MrJake222/pico-radio-docs/img/5/hw_result.jpg

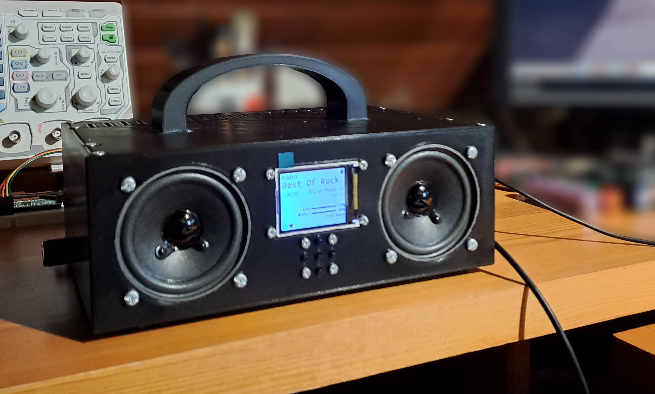
img/5/hw_result.jpg
