MrJake222/pico-radio-docs/img/5/search.jpg

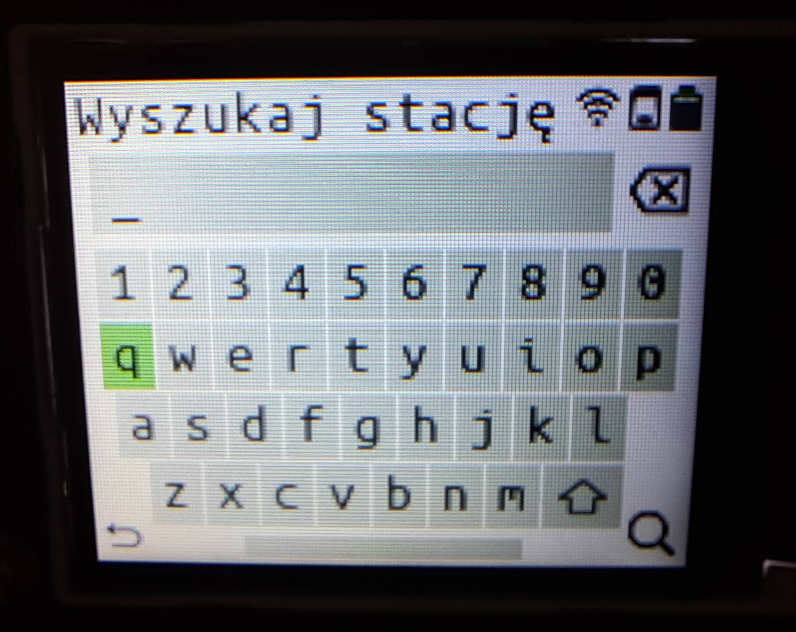
img/5/search.jpg
