MrJake222/pico-radio-docs/img/3/PicoRadio-dma-buf.pdf

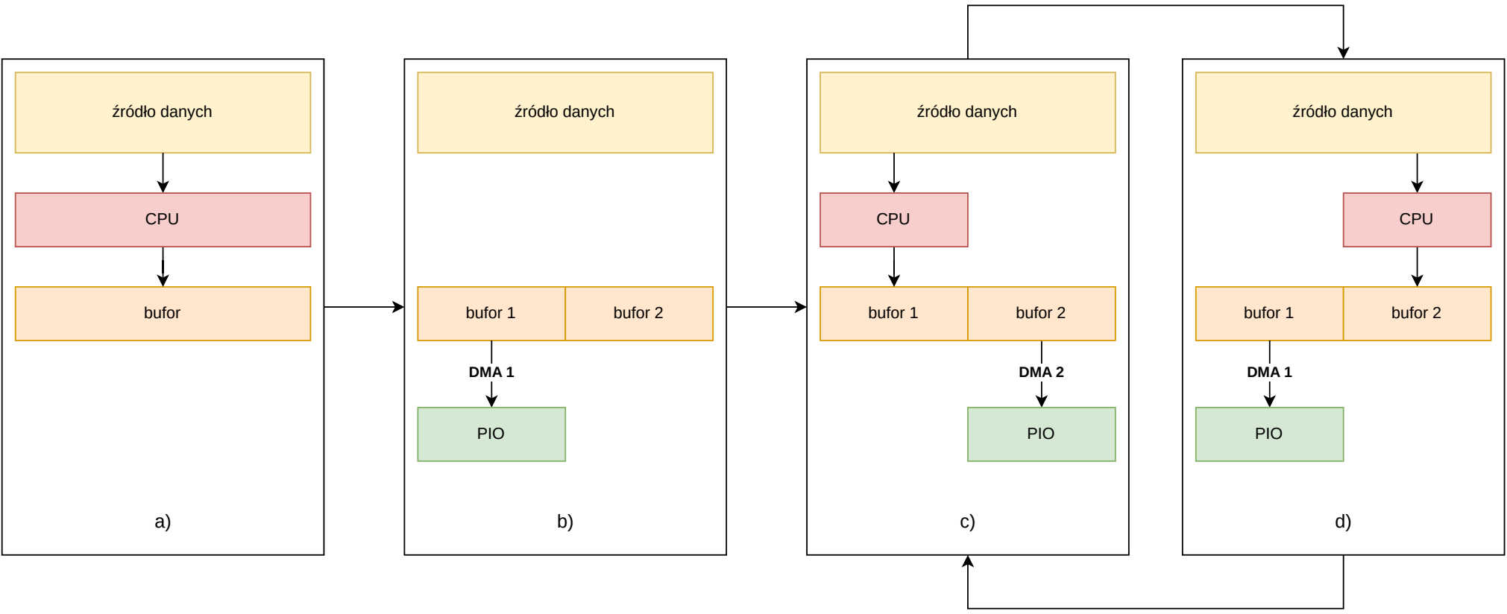
[picture p3: figure]
źródło danych; bufor 1; DMA 2; bufor 2; CPU; PIO; DMA 1; bufor
