MrJake222/pico-radio-docs/img/3/PicoRadio-buffer.pdf

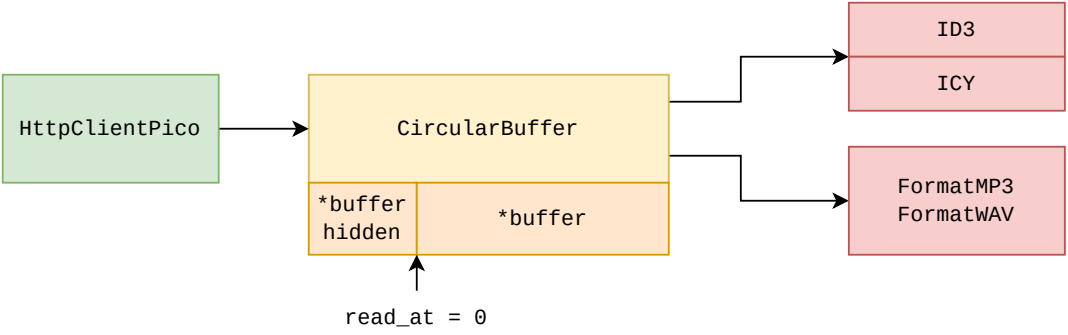
[picture p4: figure]
HttpClientPico; CircularBuffer; ICY; FormatMP3 FormatWAV *buffer; hidden; *buffer; read_at = 0
