MrJake222/pico-radio-docs/img/3/PicoRadio-code-block-diagram.pdf

FreeRTOS

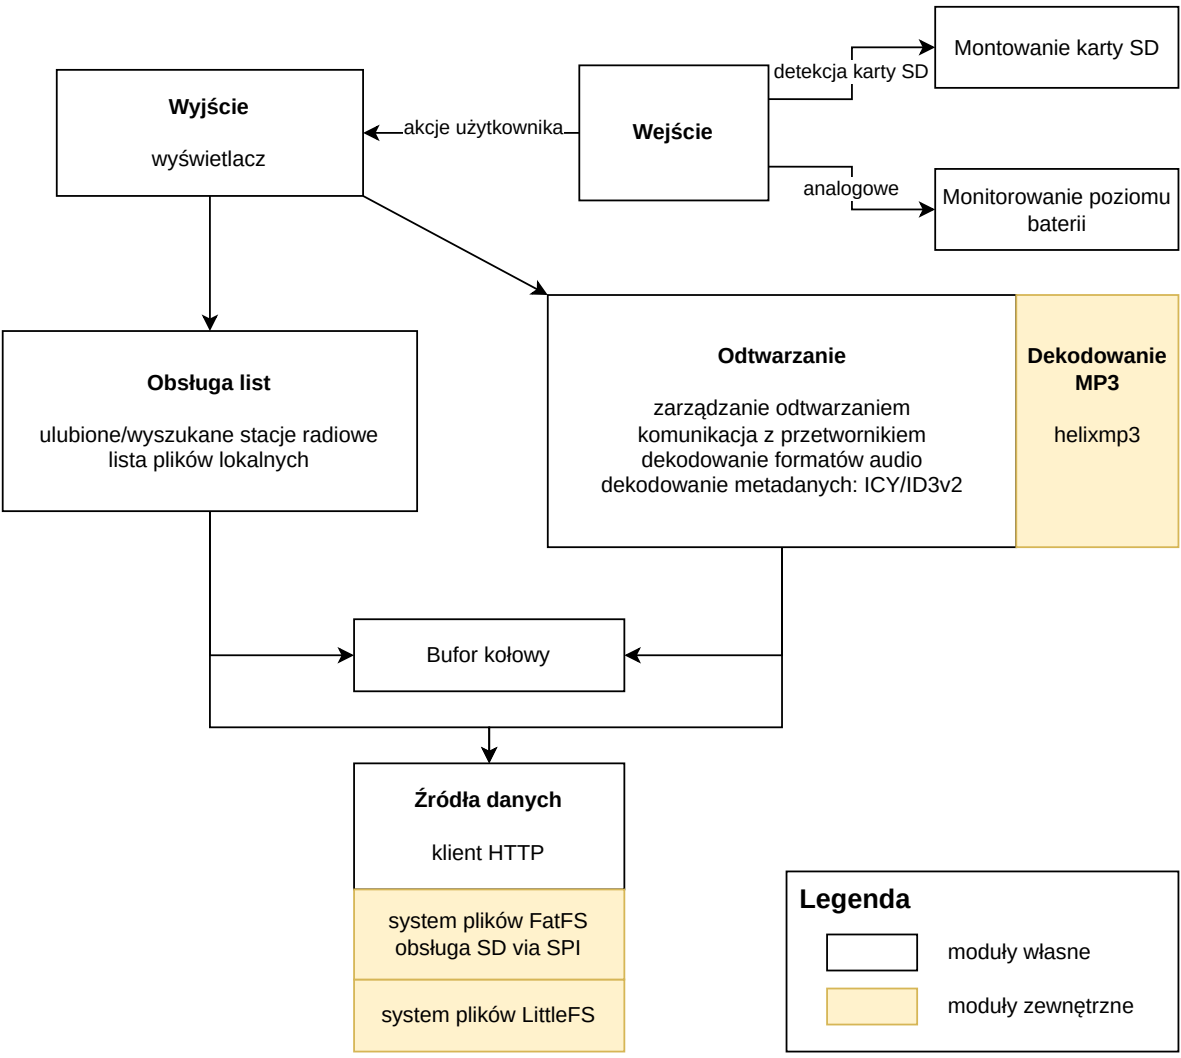
[picture p5: figure]
akcje użytkownika; analogowe; detekcja karty SD; Wejście; Wyjście; wyświetlacz; Odtwarzanie; zarządzanie odtwarzaniem komunikacja z przetwornikiem dekodowanie formatów audio dekodowanie metadanych: ICY/ID3v2; Bufor kołowy; Obsługa list; ulubione/wyszukane stacje radiowe lista plików lokalnych; Montowanie karty SD; Monitorowanie poziomu baterii; Dekodowanie MP3; helixmp3; Legenda; moduły własne; Źródła danych; klient HTTP; system plików LittleFS; system plików FatFS obsługa SD via SPI; moduły zewnętrzne
