MrJake222/pico-radio-docs/img/3/PicoRadio-icy.pdf

Ramka MP3 (np. 418 bajtów) + ramka ICY

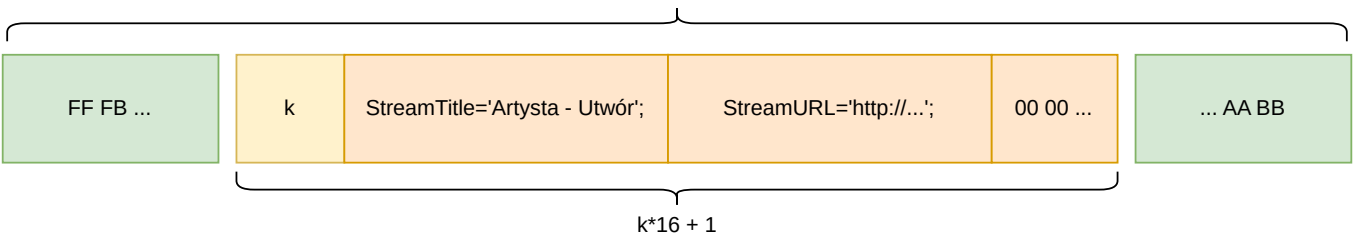
[picture p6: figure]
StreamTitle='Artysta - Utwór';; StreamURL='http://...';
