MrJake222/pico-radio-docs/img/3/PicoRadio-id3.pdf

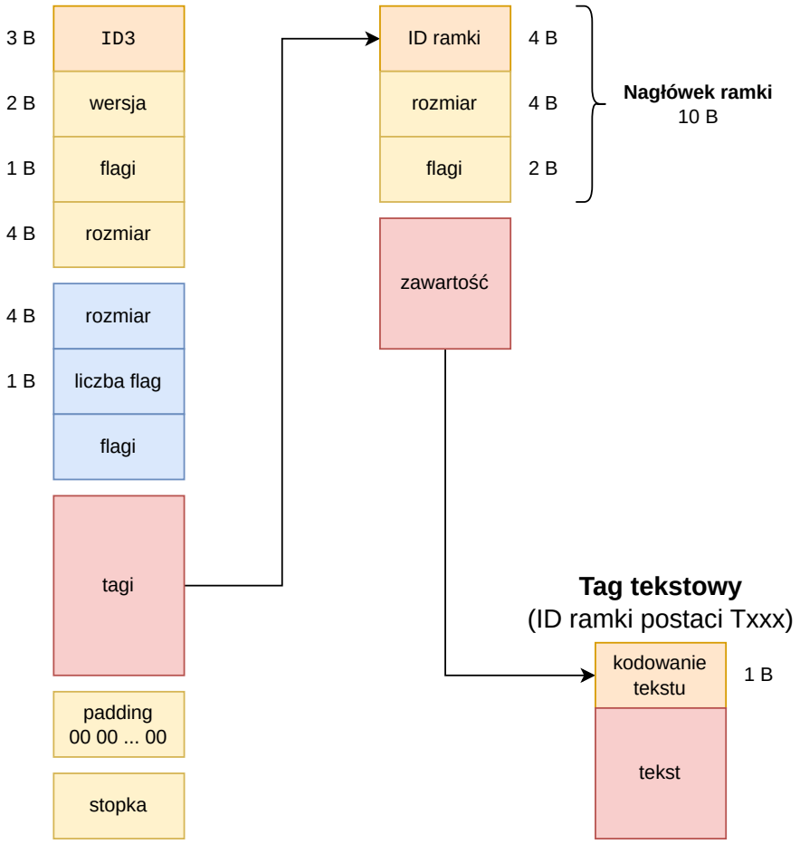
[picture p7: figure]
wersja; flagi; rozmiar; liczba flag; tagi; padding 00 00 ... 00; stopka; ID ramki; Nagłówek ramki 10 B; zawartość; kodowanie; tekstu; tekst; Tag tekstowy (ID ramki postaci Txxx)

Nagłówek
10 B

Nagłówek
rozszerzony
(opcja)
Tag ID3v2 | Ramka (tag)
