MrJake222/pico-radio-docs/img/3/PicoRadio-loaders.pdf

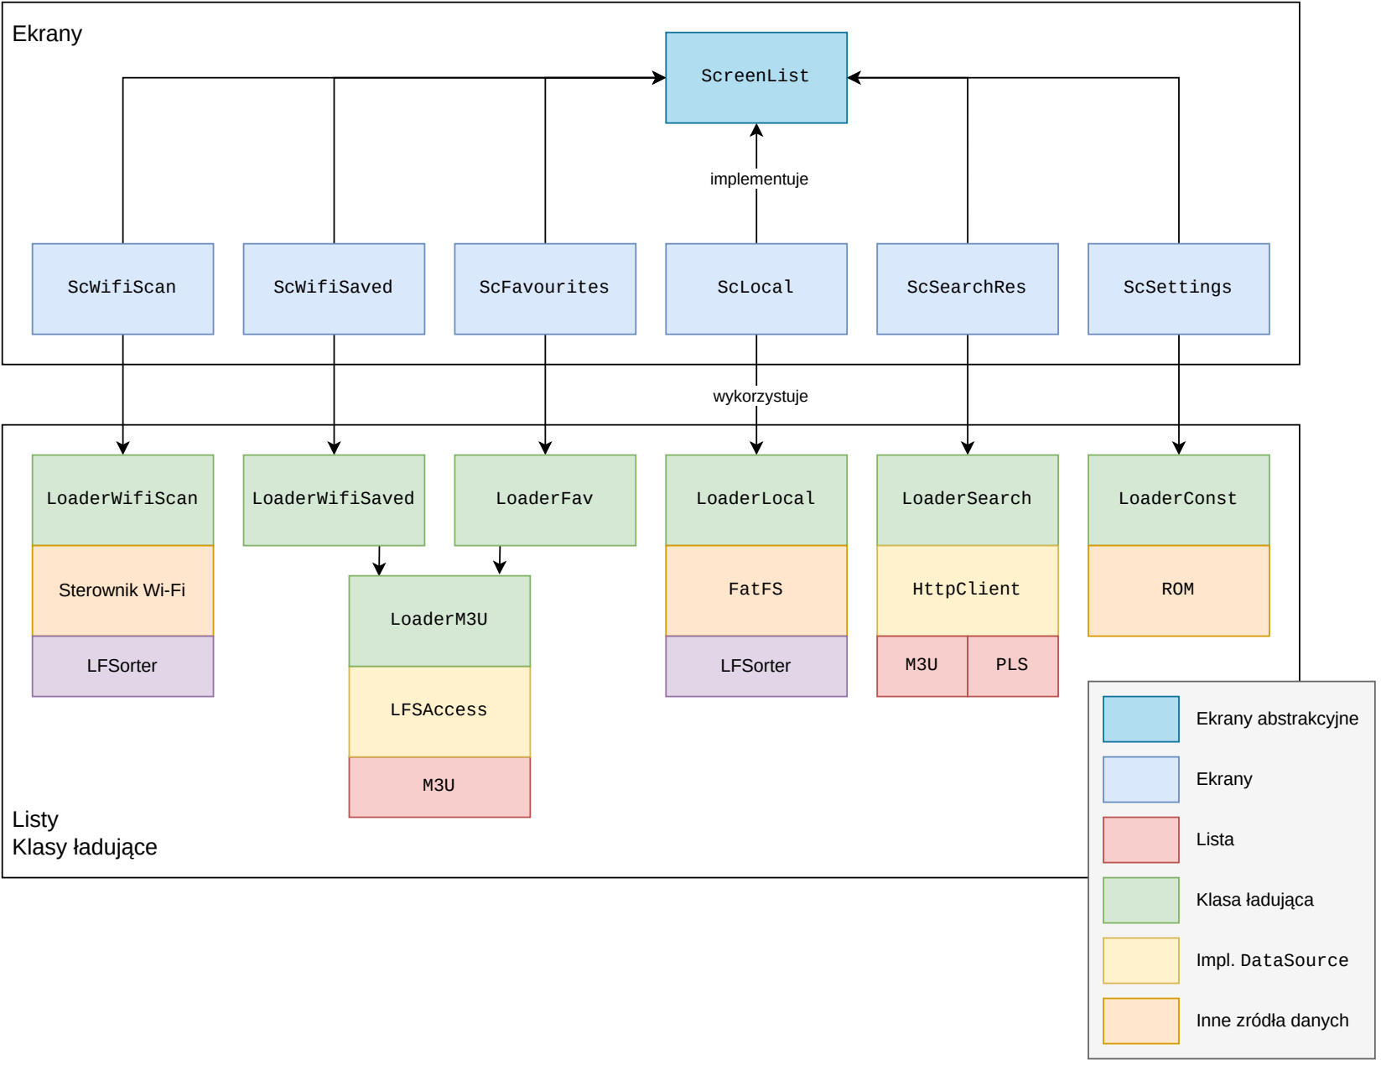
[picture p8: figure]
LoaderFav; LFSAccess; wykorzystuje; LoaderLocal; FatFS; LoaderSearch; HttpClient; PLS; ScFavourites; implementuje; ScLocal; ScSearchRes; ScreenList; Ekrany; Listy Klasy ładujące; Klasa ładująca; Lista; Impl. DataSource; Ekrany abstrakcyjne; ScWifiScan; ScWifiSaved; ScSettings; LoaderWifiScan; LoaderWifiSaved; LoaderConst; ROM; LoaderM3U; Sterownik Wi-Fi; Inne zródła danych; LFSorter
