MrJake222/pico-radio-docs/img/3/PicoRadio-screen-rect.pdf

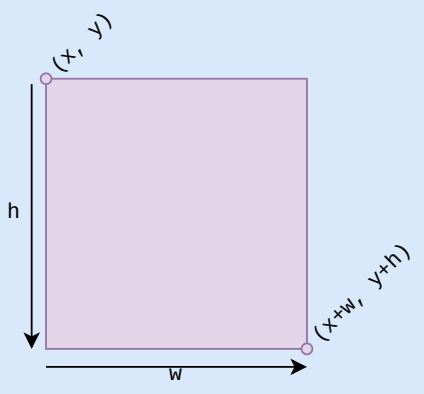
[picture p9: figure]
