MrJake222/pico-radio-docs/img/3/PicoRadio-screens.pdf

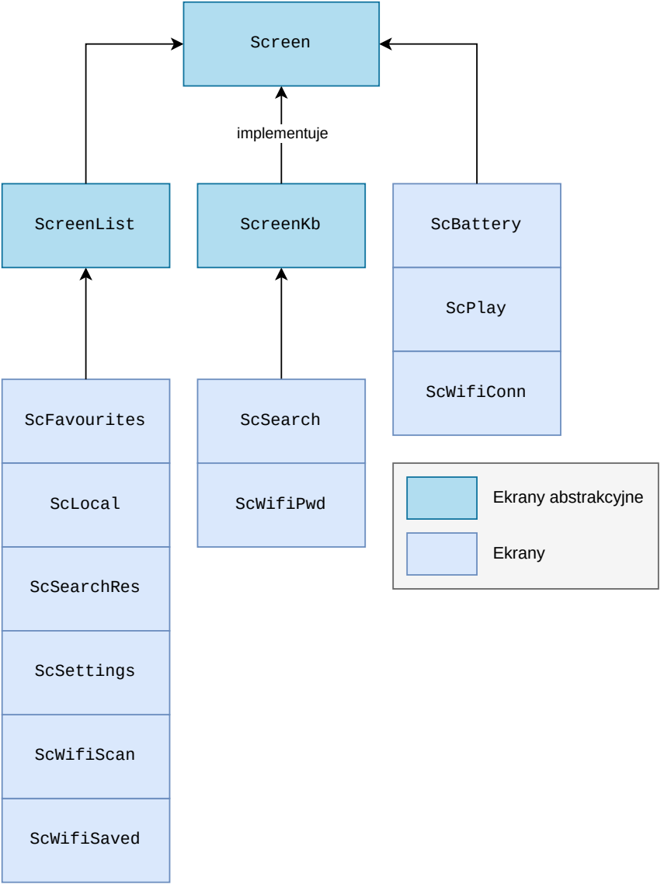
[picture p10: figure]
ScFavourites; ScLocal; ScSearchRes; ScreenList; Ekrany; Ekrany abstrakcyjne; ScSettings; ScWifiSaved; ScWifiScan; ScreenKb; ScWifiPwd; ScSearch; ScBattery; ScPlay; ScWifiConn; implementuje; Screen
