MrJake222/pico-radio-docs/img/1/botland_stm.jpg

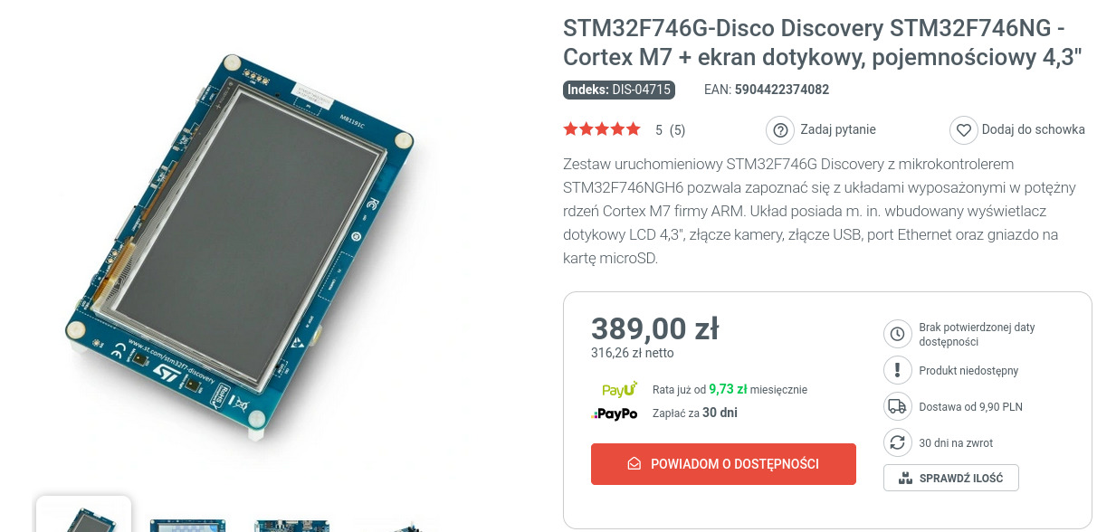
img/1/botland_stm.jpg
