MrJake222/pico-radio-docs/img/1/radio_adapter.jpg

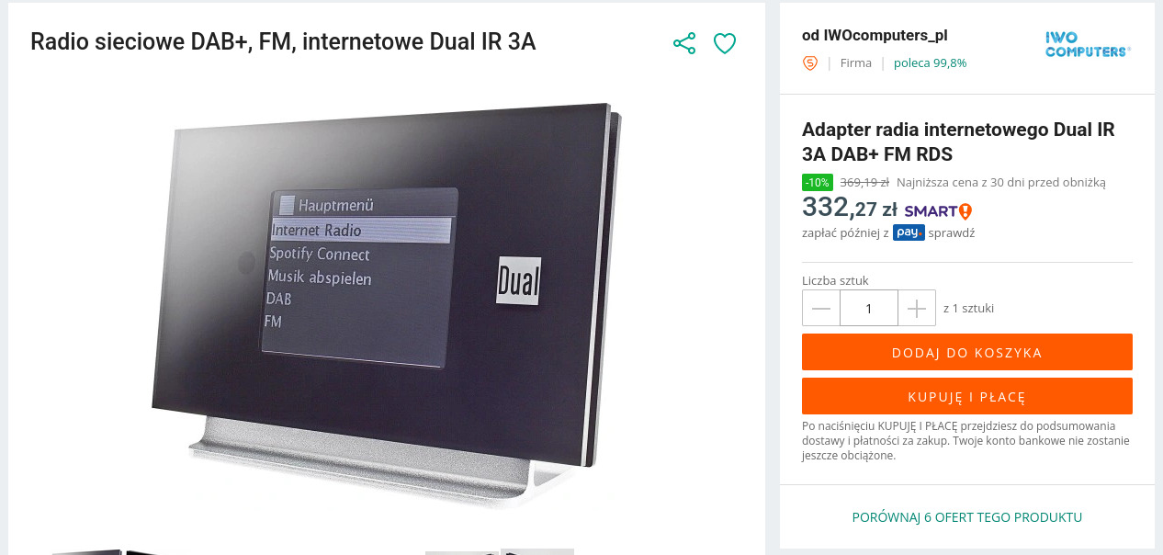
img/1/radio_adapter.jpg
