MrJake222/pico-radio-docs/img/1/radio_drogie.jpg

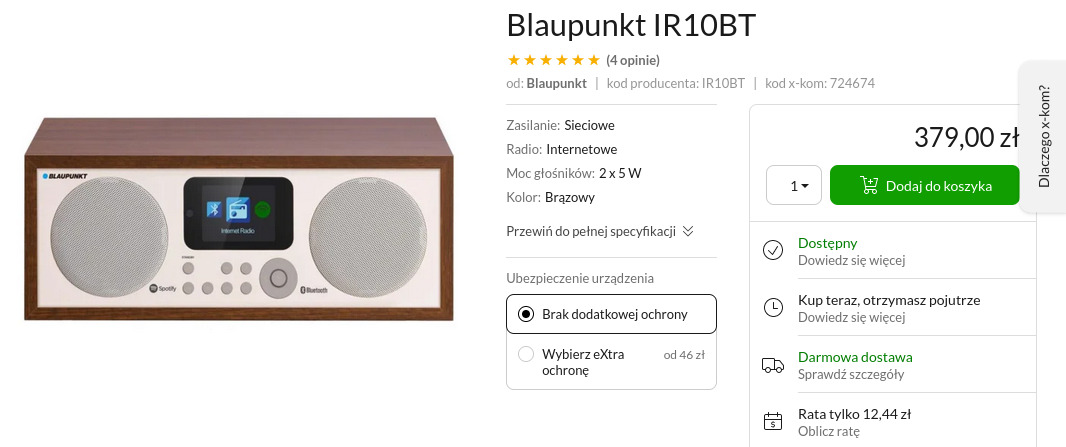
img/1/radio_drogie.jpg
