MrJake222/pico-radio-docs/img/1/radio_proj_trimmed.jpg

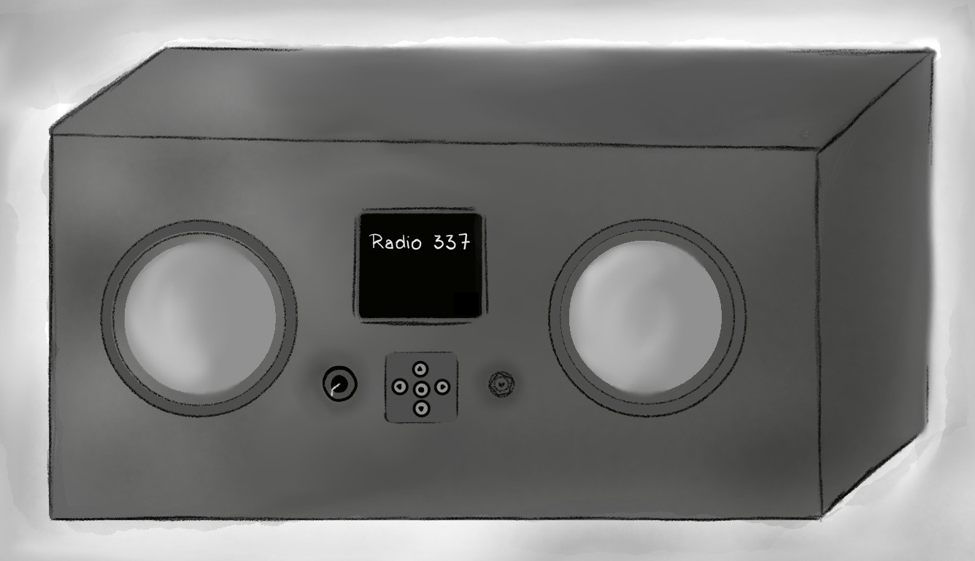
img/1/radio_proj_trimmed.jpg
