MrJake222/pico-radio-docs/img/1/radio_tanie.jpg

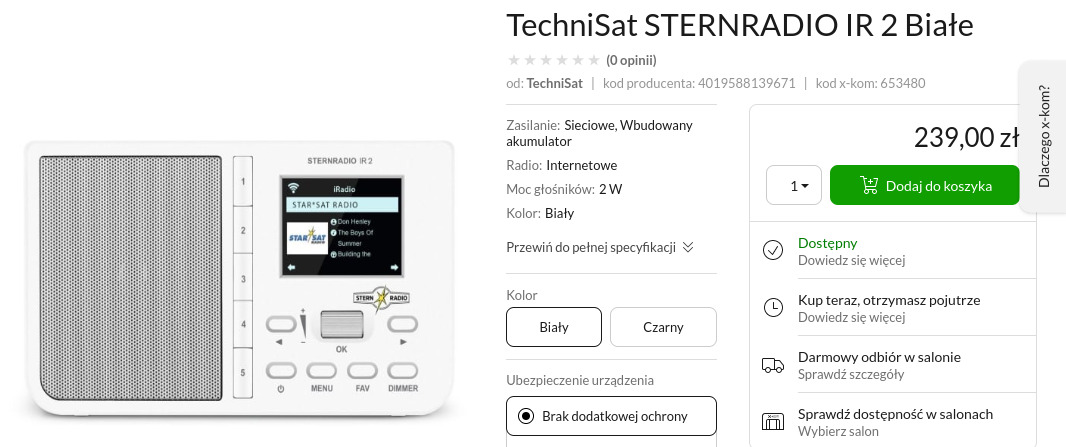
img/1/radio_tanie.jpg
