MrJake222/pico-radio-docs/img/2/btn/1.png

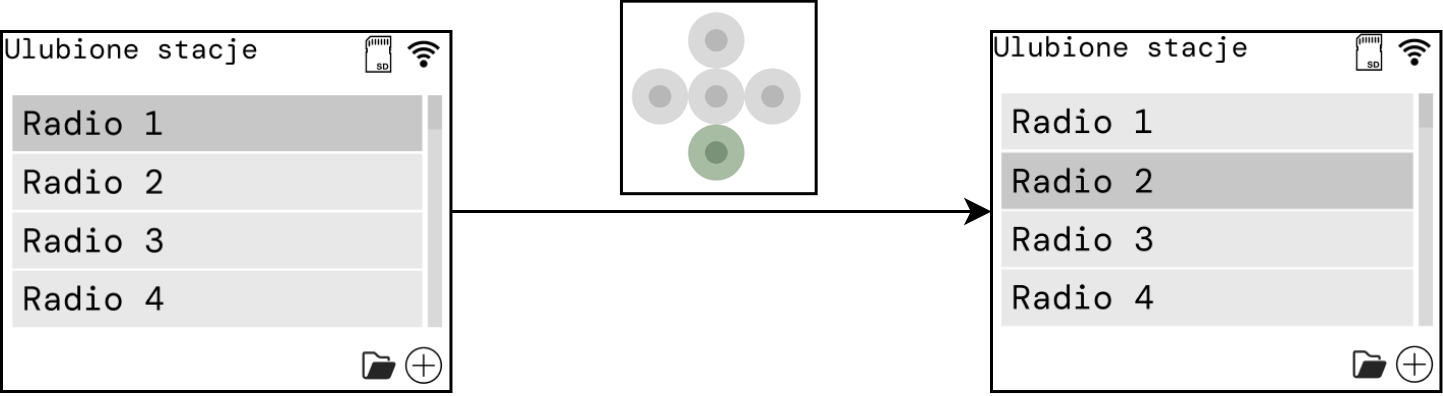
img/2/btn/1.png
