MrJake222/pico-radio-docs/img/2/btn/2.png

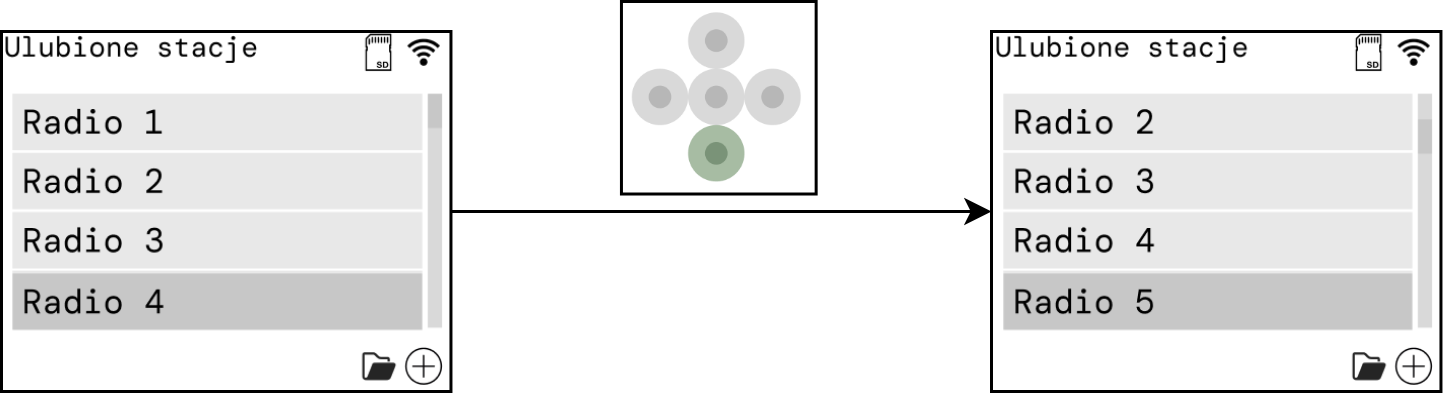
img/2/btn/2.png
