MrJake222/pico-radio-docs/img/2/btn/3.png

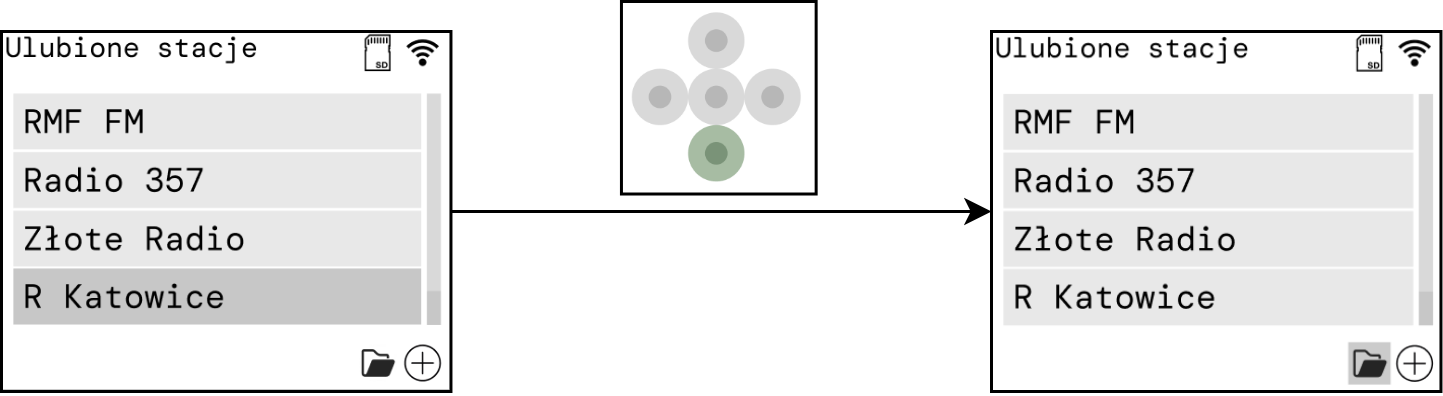
img/2/btn/3.png
