MrJake222/pico-radio-docs/img/2/btn/5.png

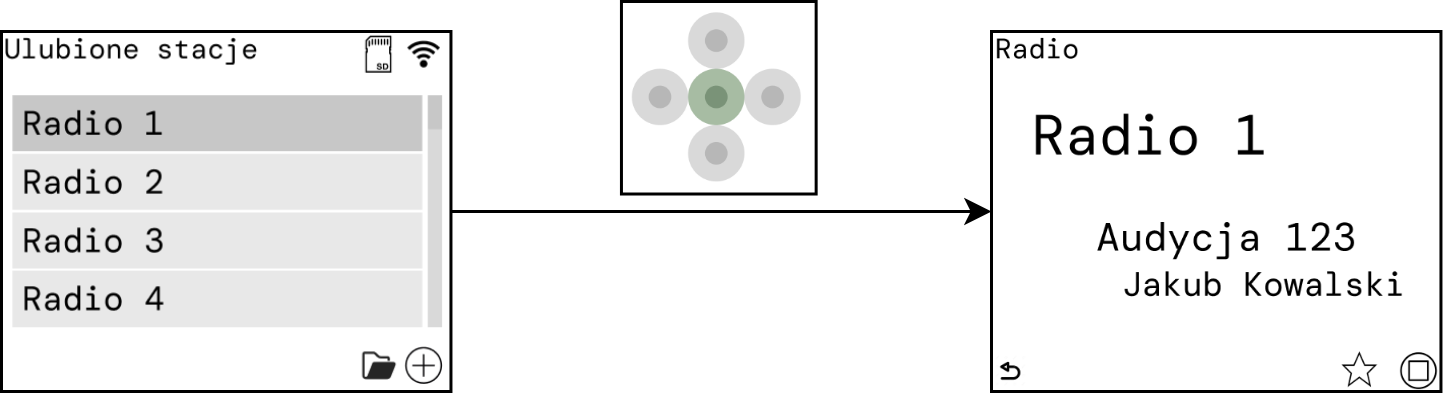
img/2/btn/5.png
