MrJake222/pico-radio-docs/img/2/err1.jpg

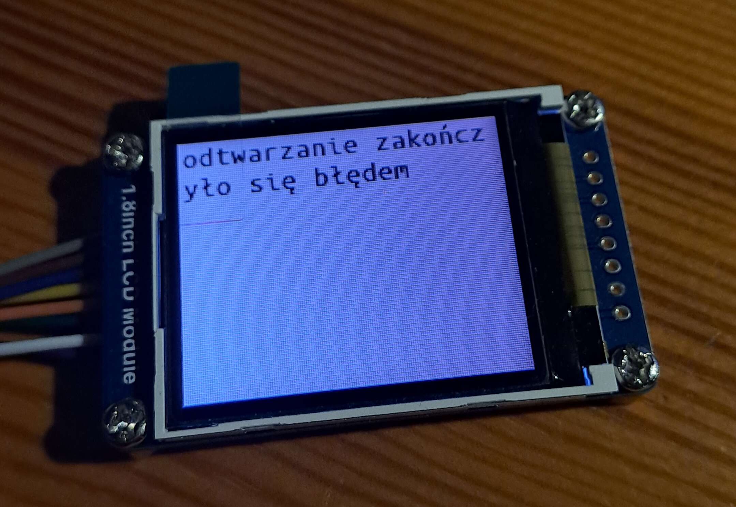
img/2/err1.jpg
