MrJake222/pico-radio-docs/img/2/err2.jpg

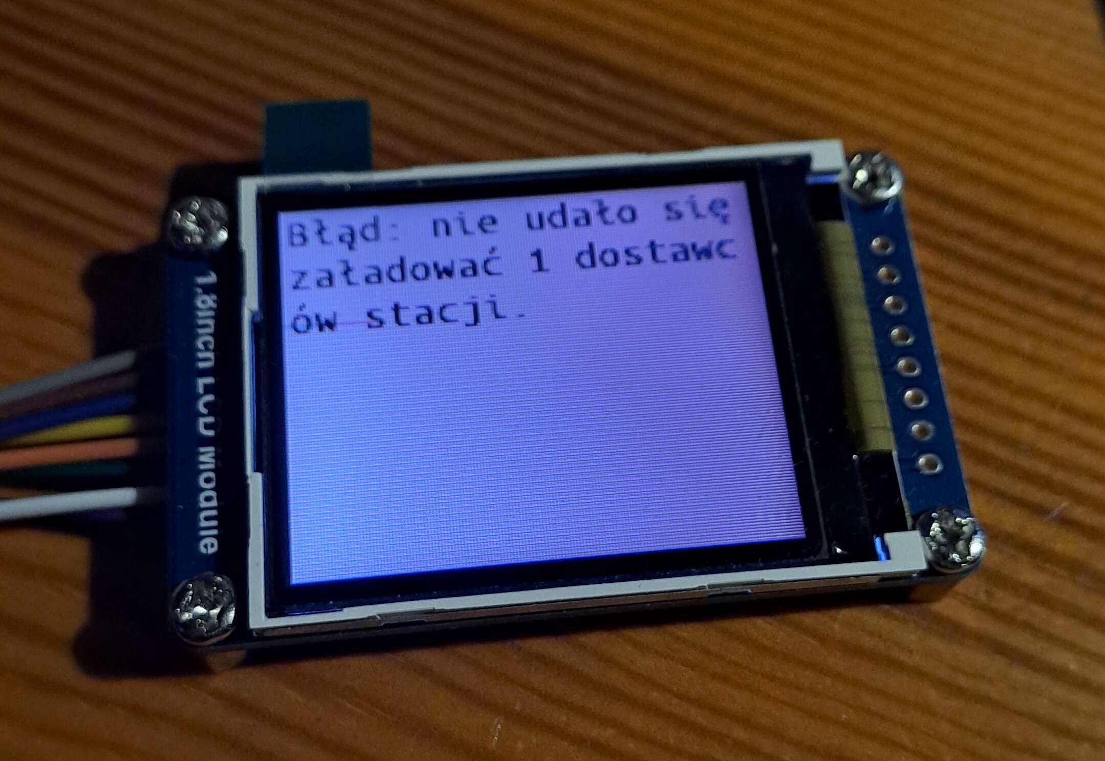
img/2/err2.jpg
