MrJake222/pico-radio-docs/img/2/interface/real1.jpg

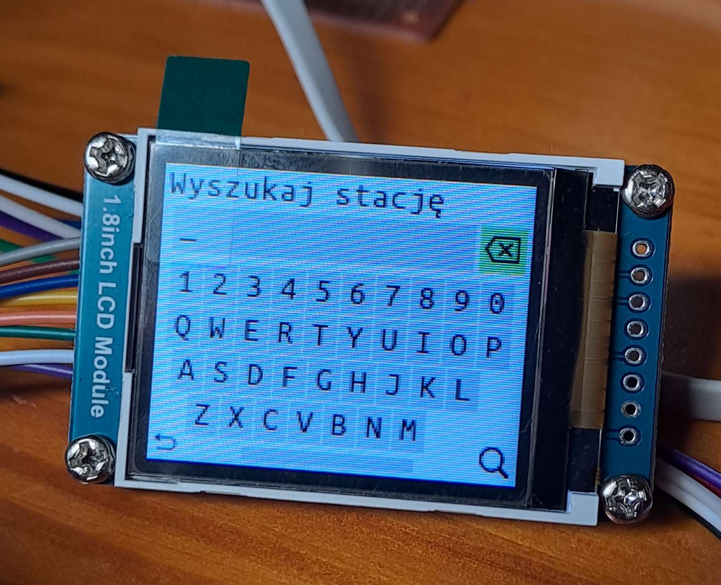
img/2/interface/real1.jpg
