MrJake222/pico-radio-docs/img/2/interface/real2.jpg

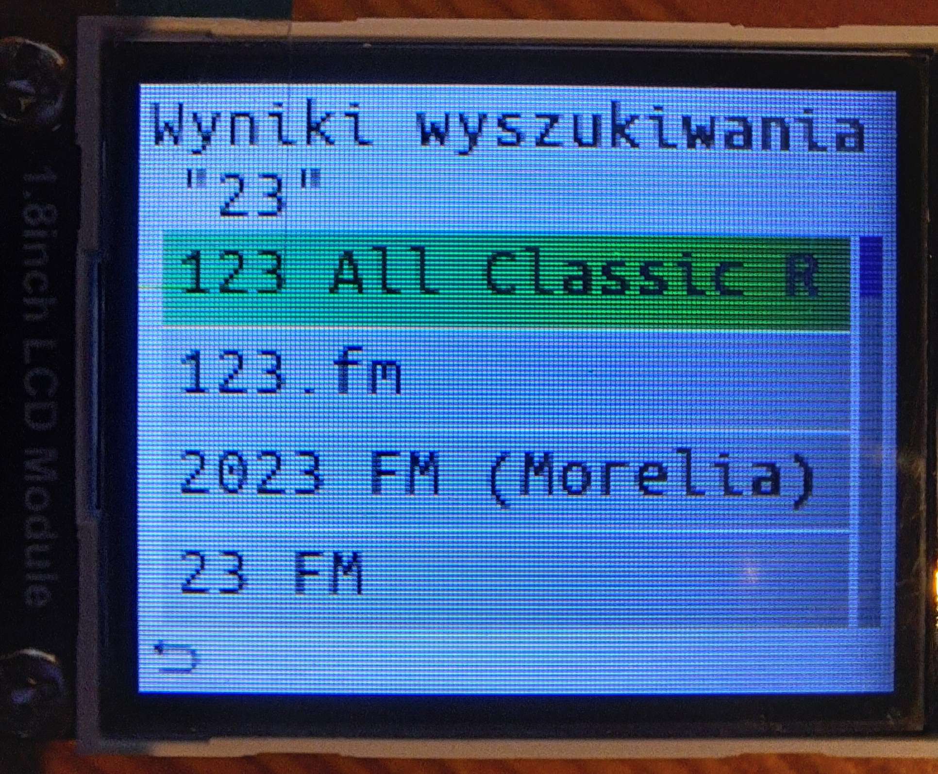
img/2/interface/real2.jpg
