MrJake222/pico-radio-docs/img/3/hw_case.jpg

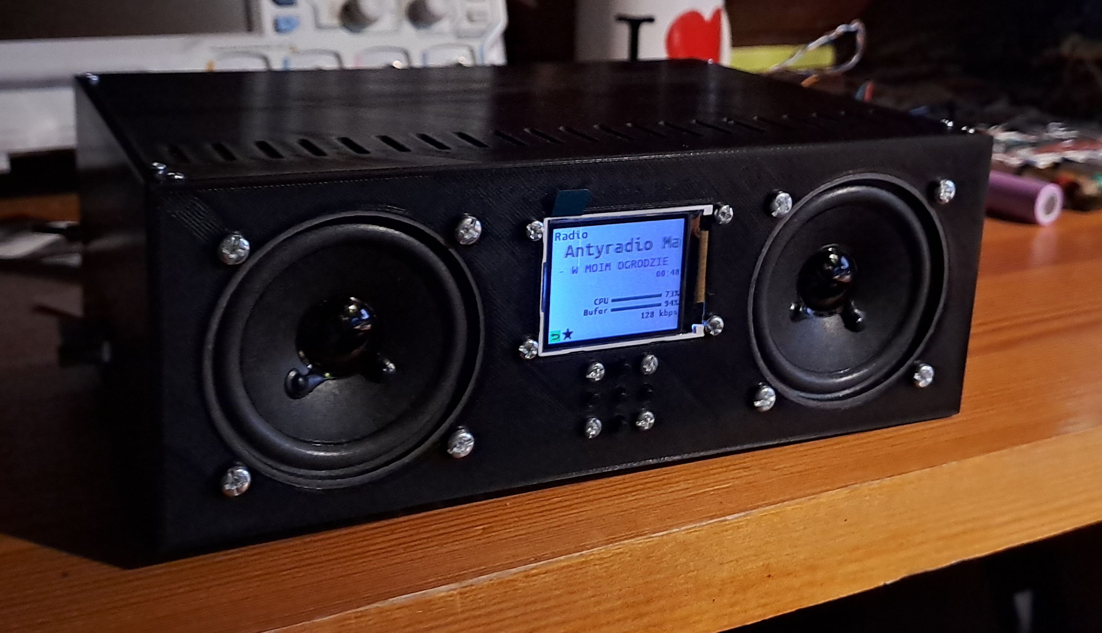
img/3/hw_case.jpg
