MrJake222/pico-radio-docs/img/3/hw_kicad_pcb.png

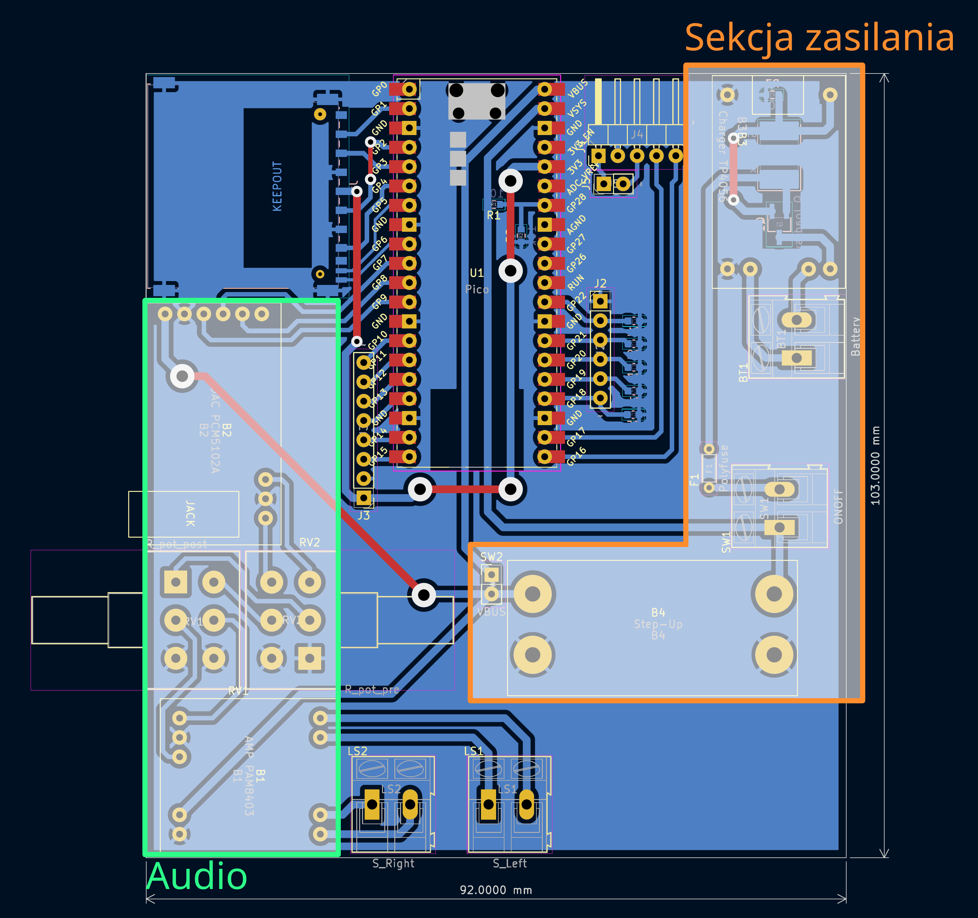
img/3/hw_kicad_pcb.png
