MrJake222/pico-radio-docs/img/3/hw_kicad_sch_audio.png

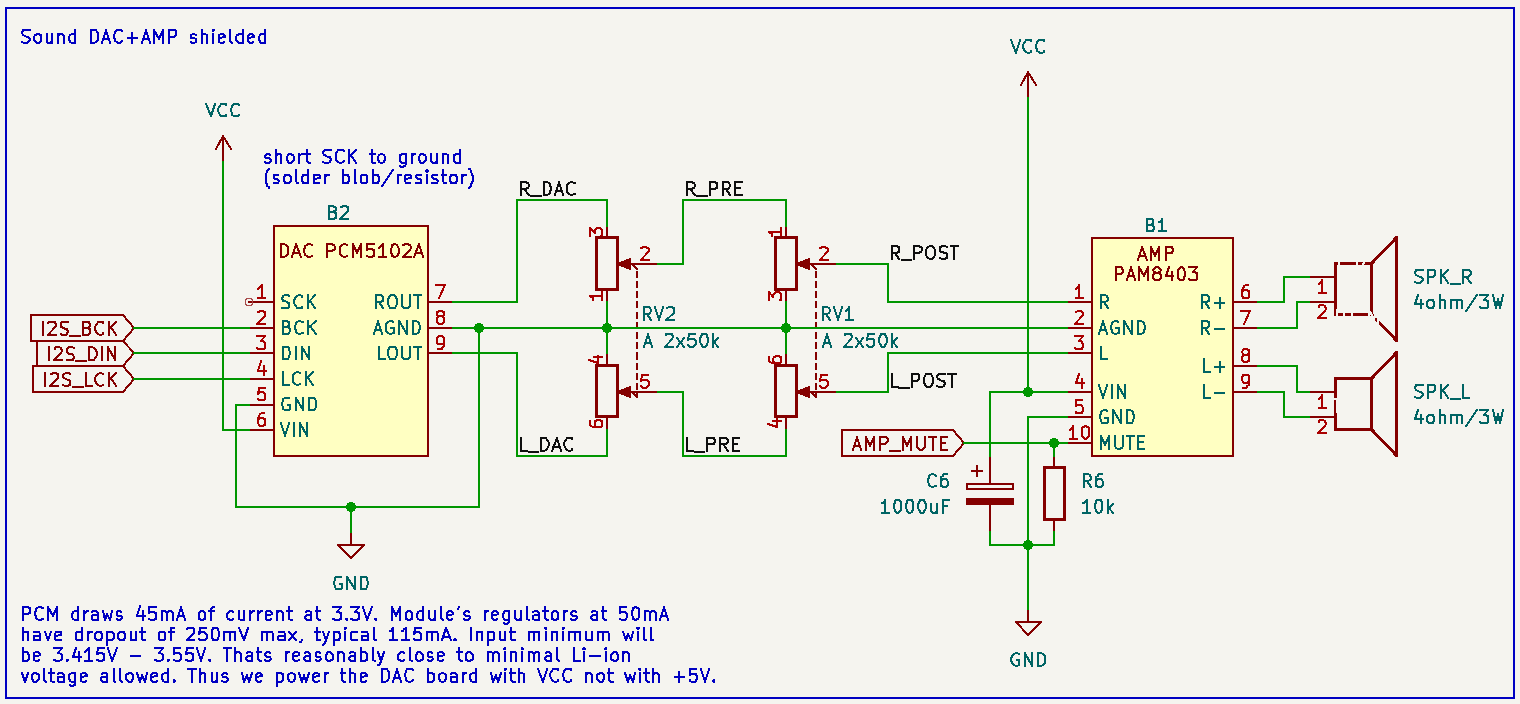
img/3/hw_kicad_sch_audio.png
