MrJake222/pico-radio-docs/img/3/hw_pcb.jpg

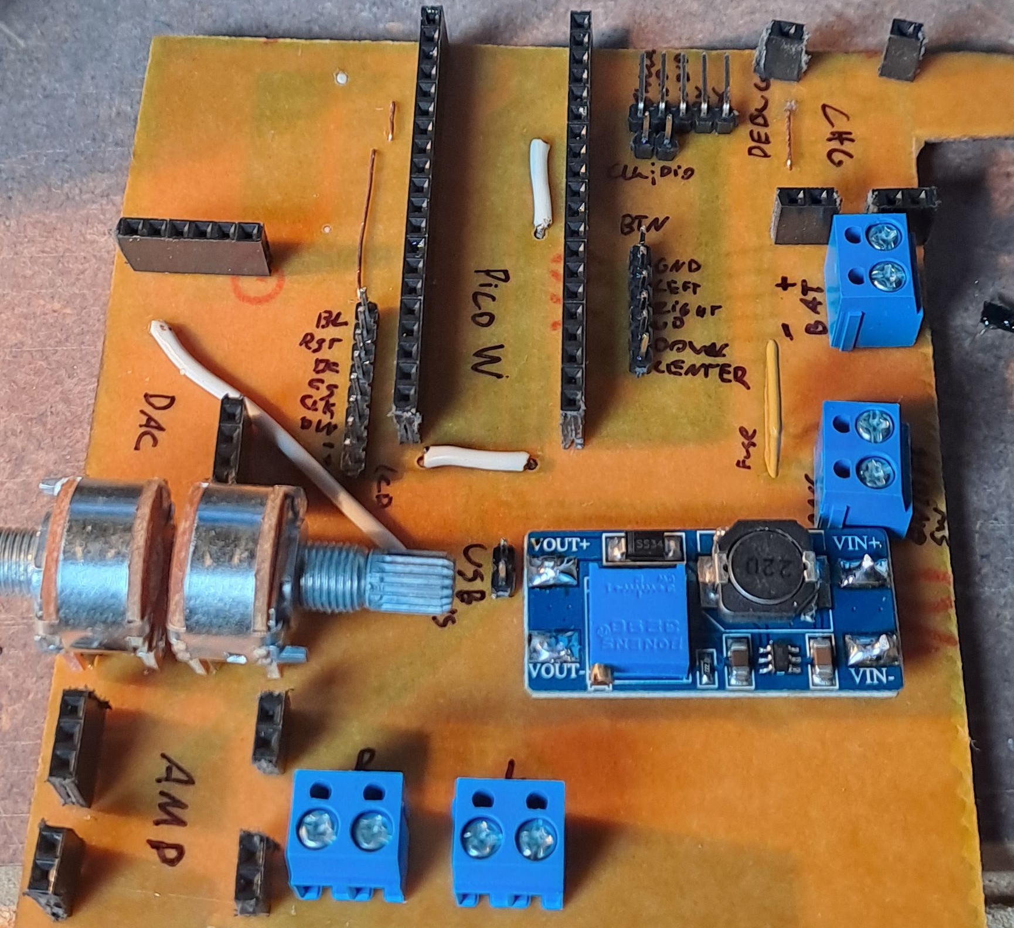
img/3/hw_pcb.jpg
