MrJake222/pico-radio-docs/img/3/hw_scad_case.png

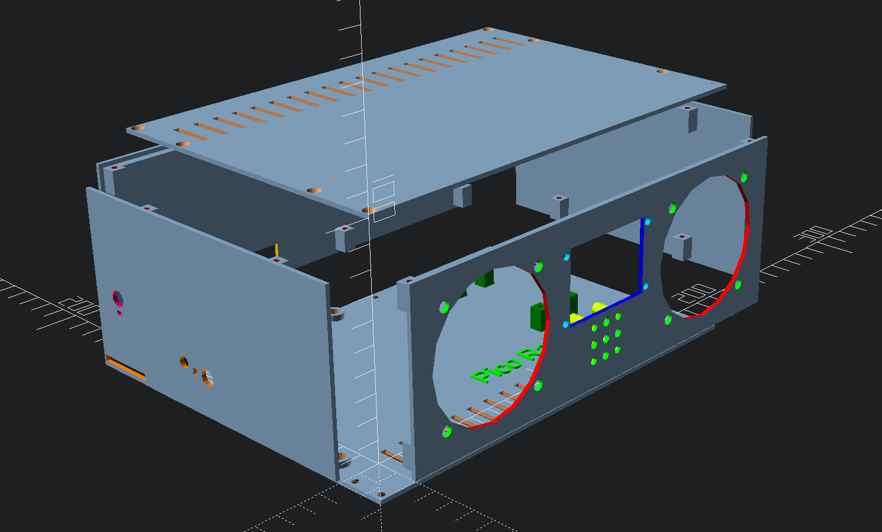
img/3/hw_scad_case.png
