MrJake222/pico-radio-docs/img/3/pio_block.jpg

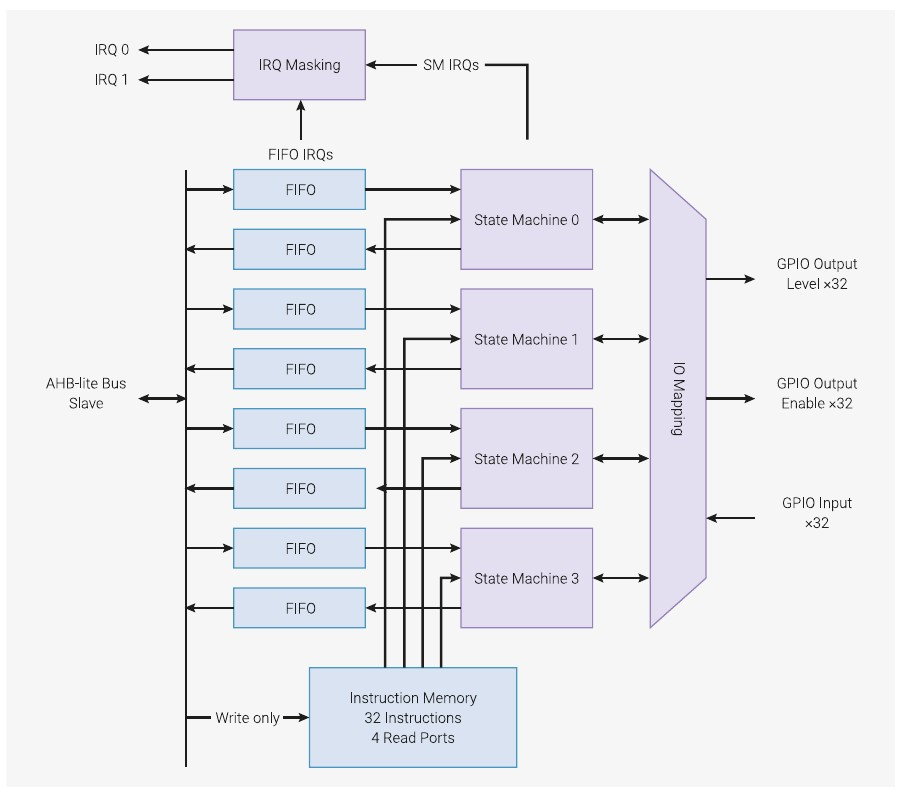
img/3/pio_block.jpg
