MrJake222/pico-radio-docs/img/3/pio_i2s_docs.jpg

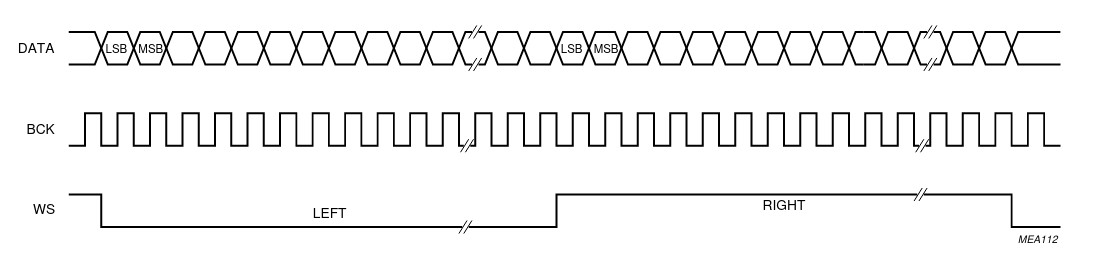
img/3/pio_i2s_docs.jpg
