MrJake222/pico-radio-docs/img/3/pio_instr.jpg

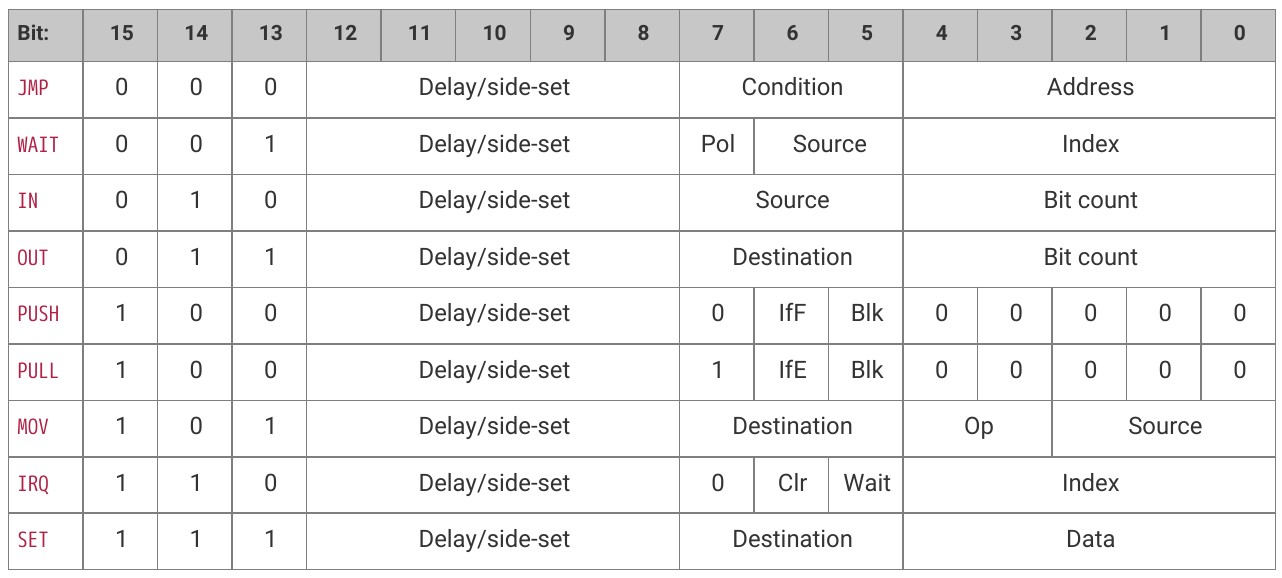
img/3/pio_instr.jpg
