MrJake222/pico-radio-docs/img/3/pipeline.jpg

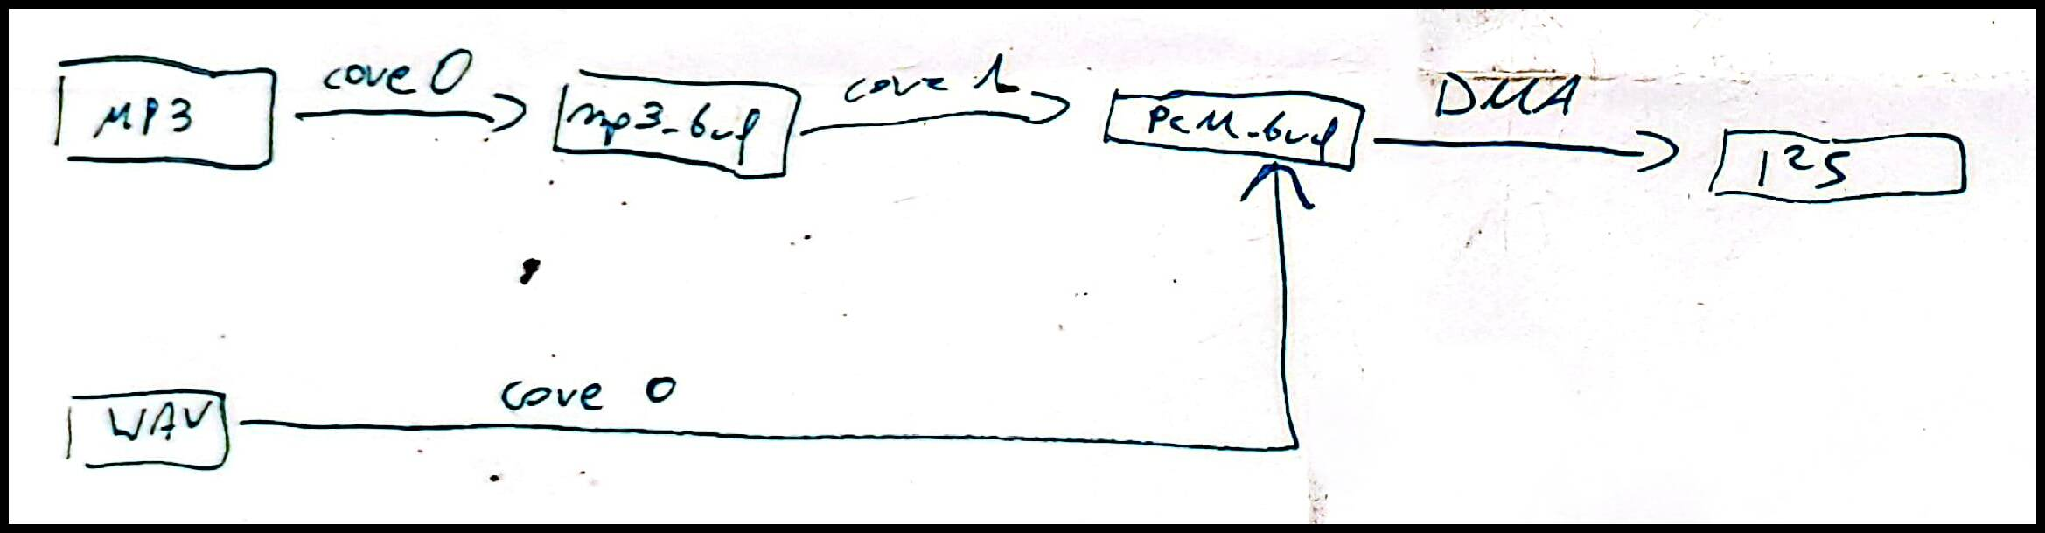
img/3/pipeline.jpg
