MrJake222/pico-radio-docs/img/3/pr_wav.jpg

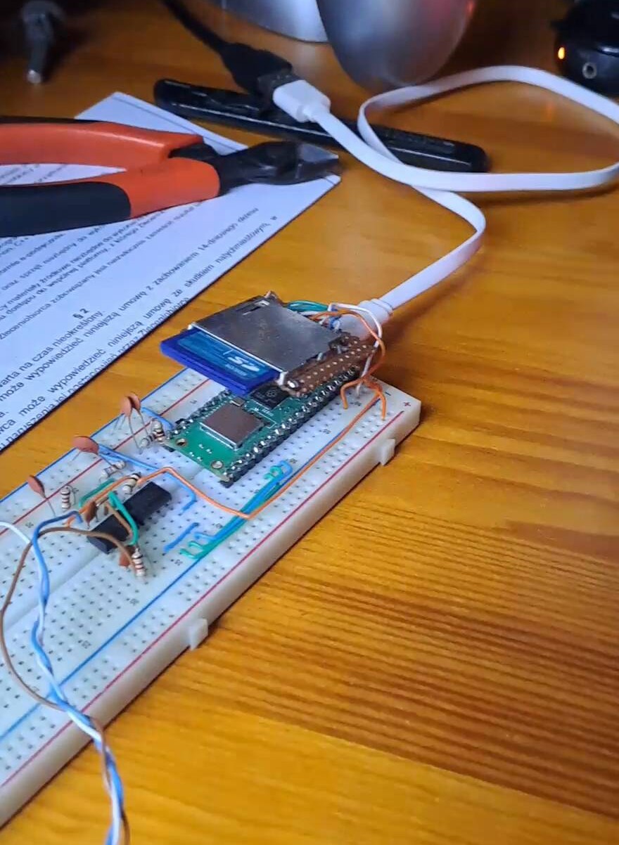
img/3/pr_wav.jpg
