MrJake222/pico-radio-docs/img/3/rb_chart.jpg

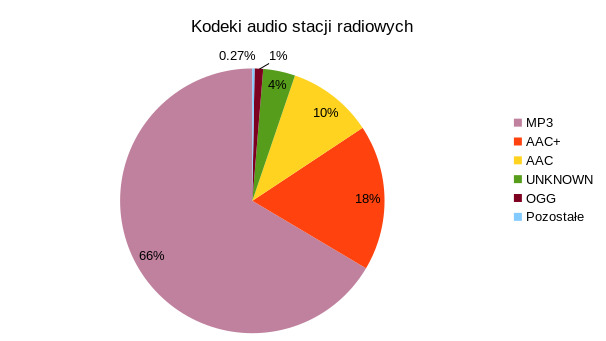
img/3/rb_chart.jpg
