MrJake222/pico-radio-docs/img/3/rb_chart_new.jpg

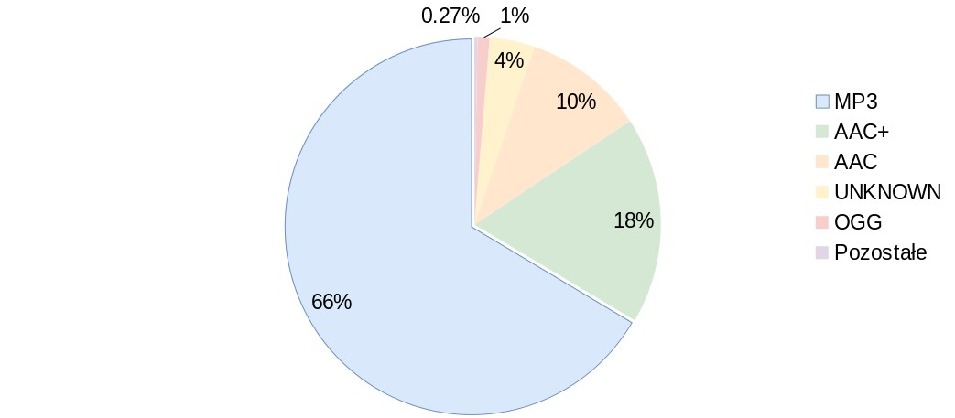
img/3/rb_chart_new.jpg
