MrJake222/pico-radio-docs/img/4/case1.jpeg

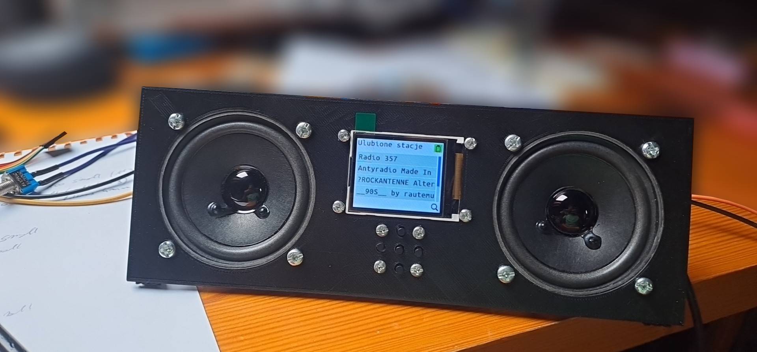
img/4/case1.jpeg
