MrJake222/pico-radio-docs/img/4/first_screen_res.jpg

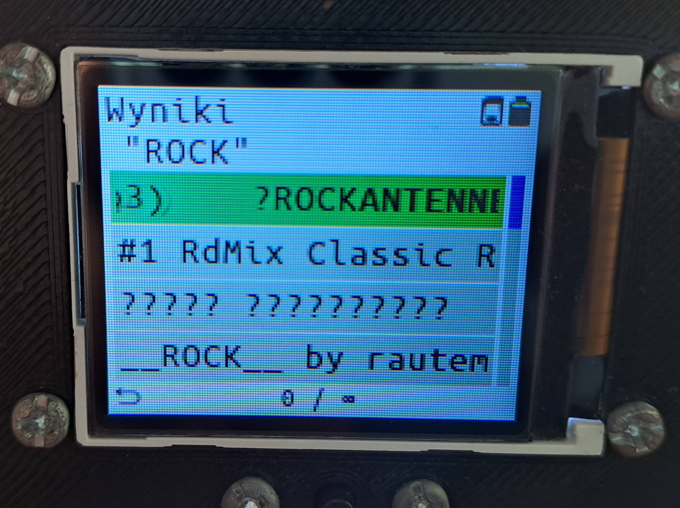
img/4/first_screen_res.jpg
