MrJake222/pico-radio-docs/img/4/first_screen_search.jpg

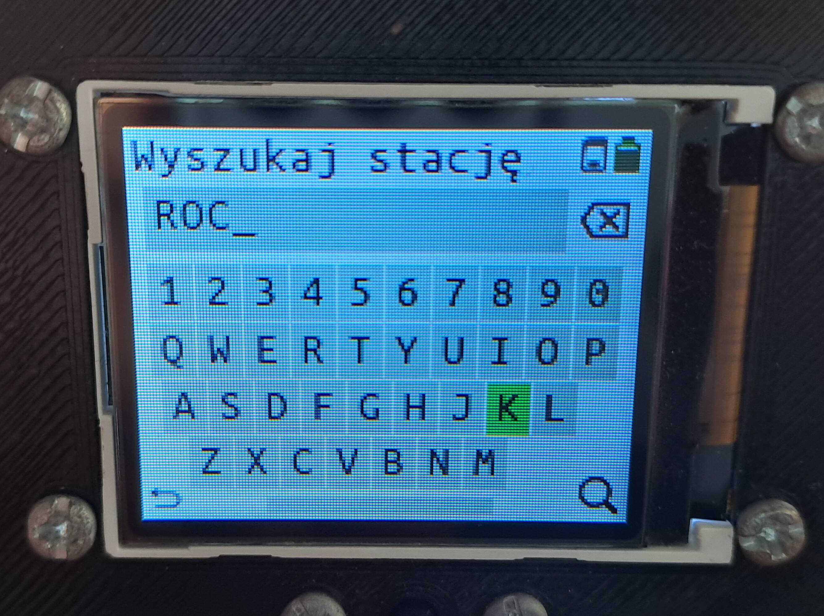
img/4/first_screen_search.jpg
