MrJake222/pico-radio-docs/img/4/pcb.jpg

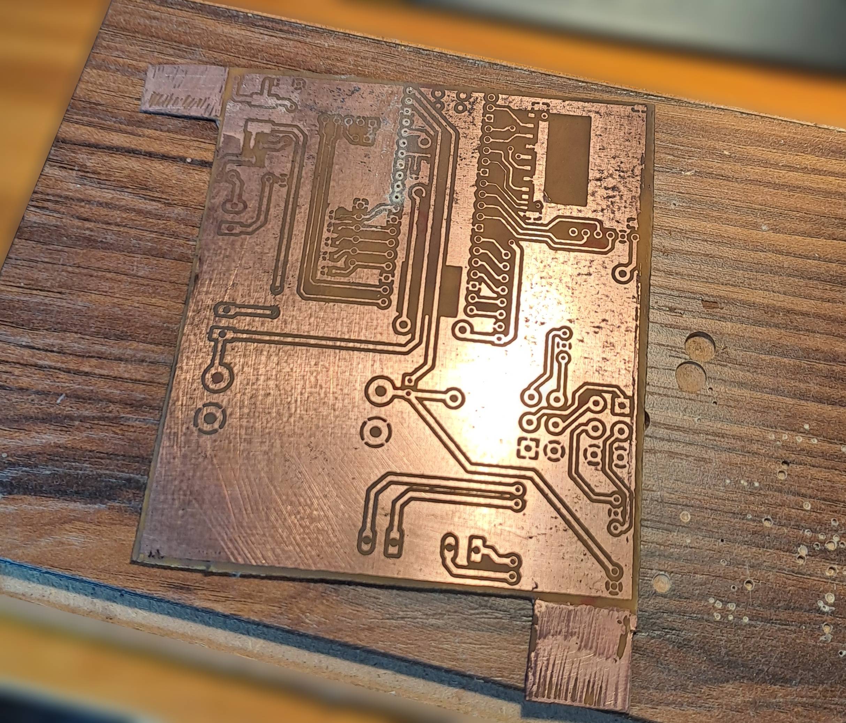
img/4/pcb.jpg
