MrJake222/pico-radio-docs/img/4/plan1.jpg

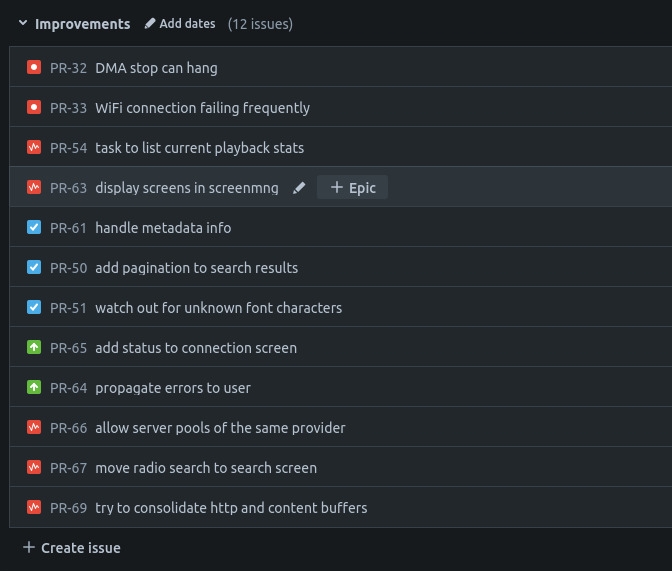
img/4/plan1.jpg
