MrJake222/pico-radio-docs/img/4/plan2.jpg

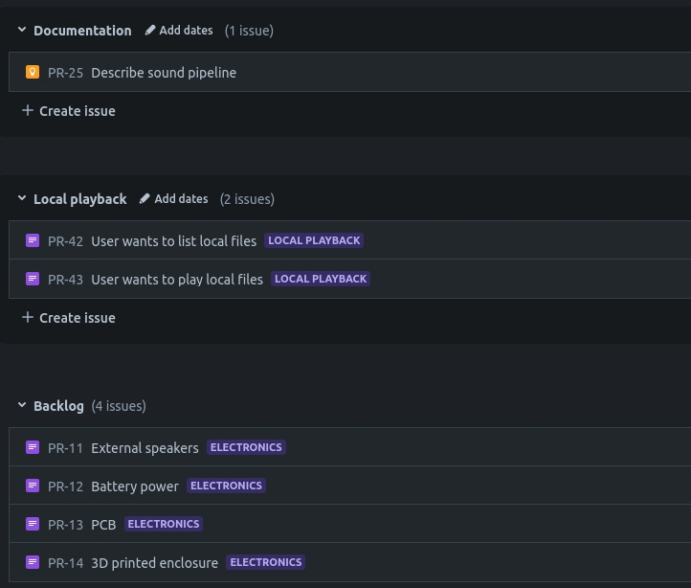
img/4/plan2.jpg
