MrJake222/pico-radio-docs/img/4/prototype_1.jpg

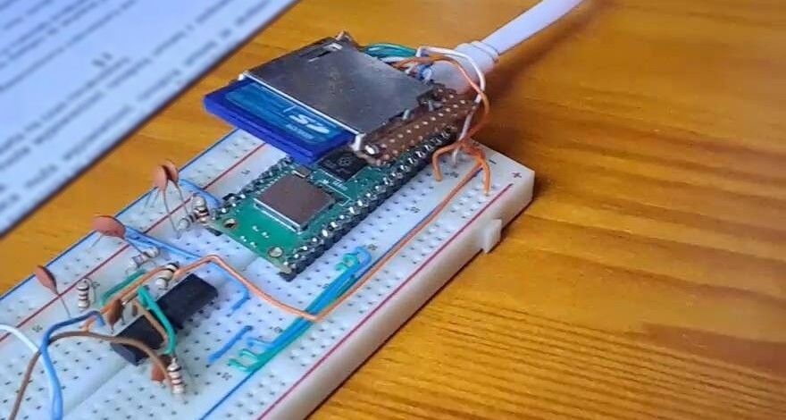
img/4/prototype_1.jpg
