MrJake222/pico-radio-docs/img/4/prototype_2.jpg

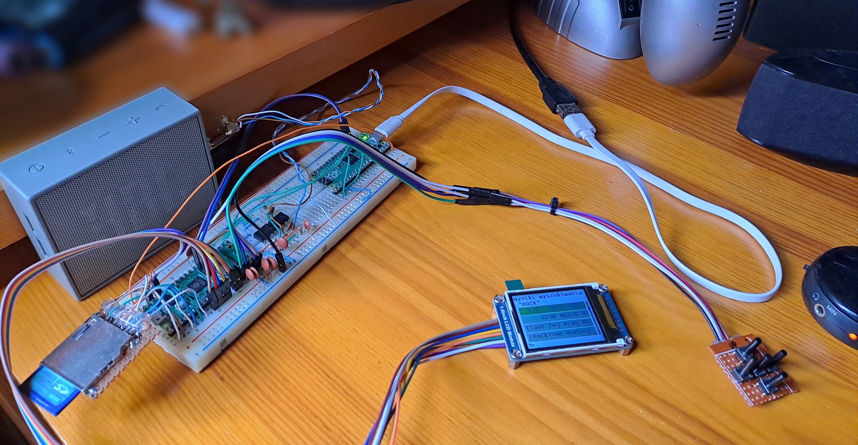
img/4/prototype_2.jpg
