MrJake222/pico-radio-docs/img/4/scr_player.jpg

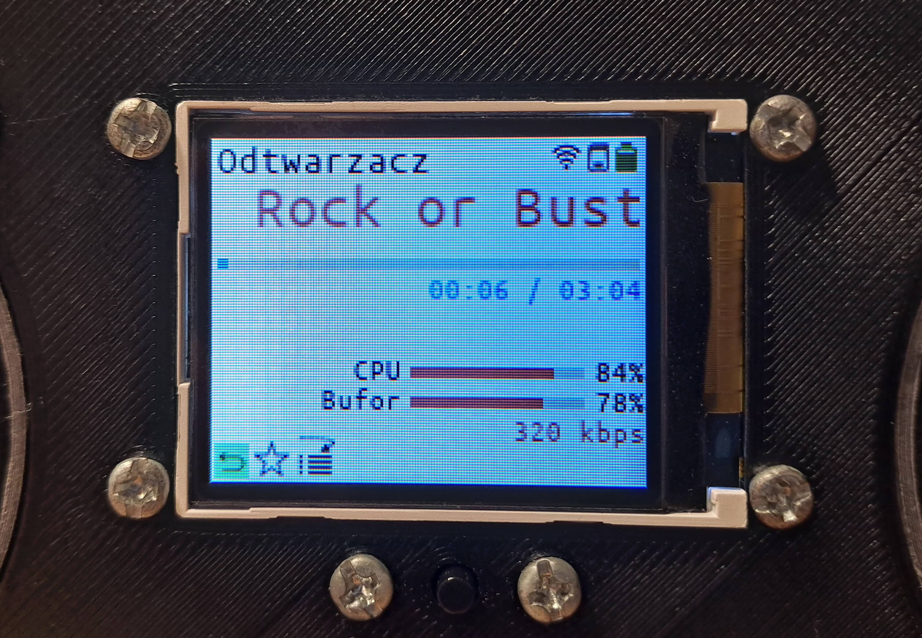
img/4/scr_player.jpg
