MrJake222/pico-radio-docs/img/4/scr_radio.jpg

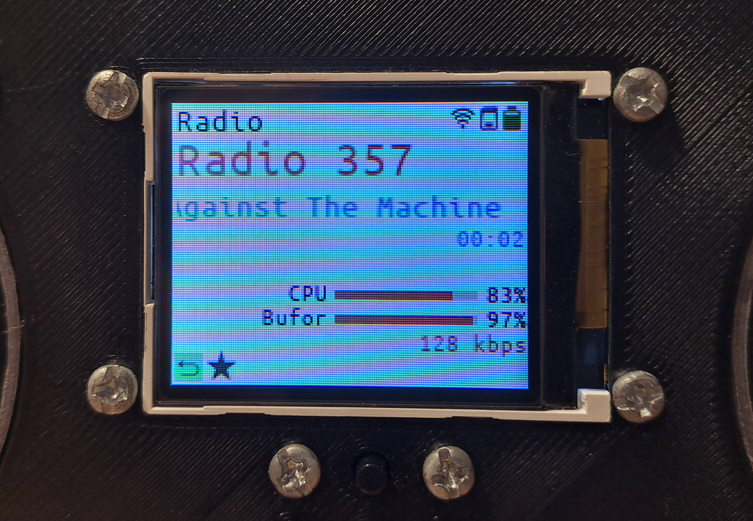
img/4/scr_radio.jpg
