MrJake222/pico-radio-docs/img/4/tcp_fail.jpg

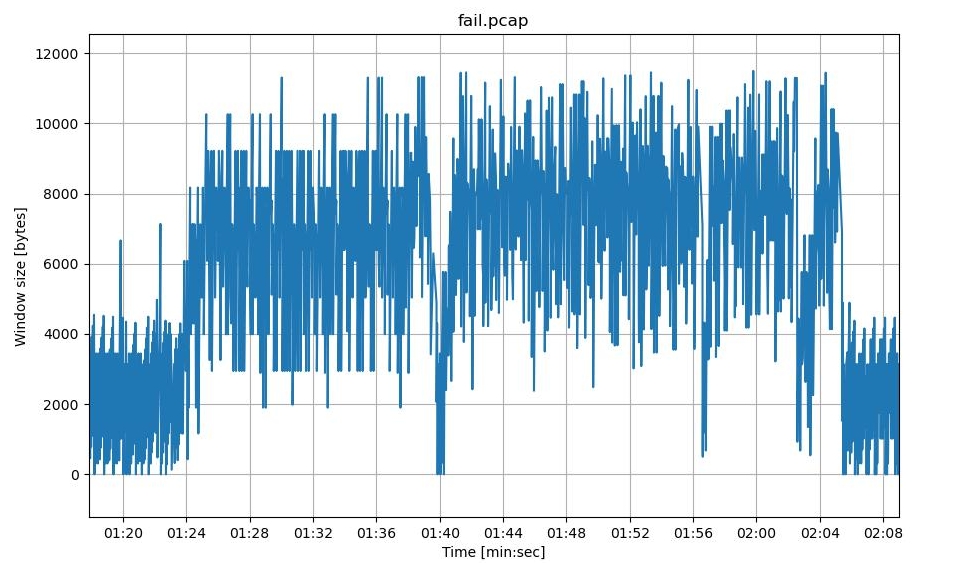
img/4/tcp_fail.jpg
