MrJake222/pico-radio-docs/img/4/tcp_good.jpg

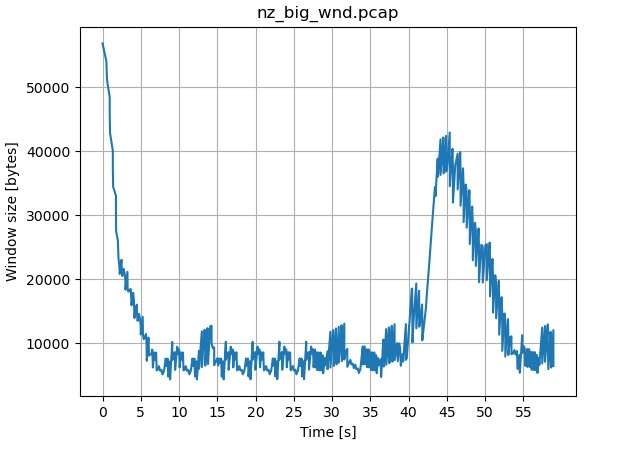
img/4/tcp_good.jpg
