MrJake222/pico-radio-docs/img/5/fav.jpg

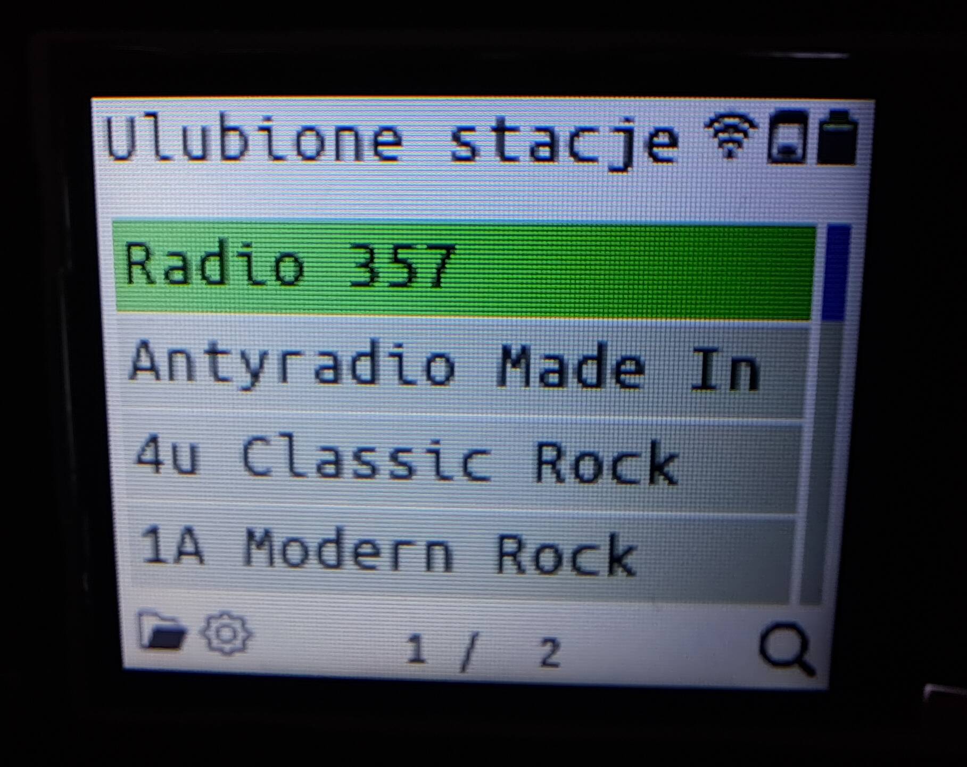
img/5/fav.jpg
