MrJake222/pico-radio-docs/img/5/local.jpg

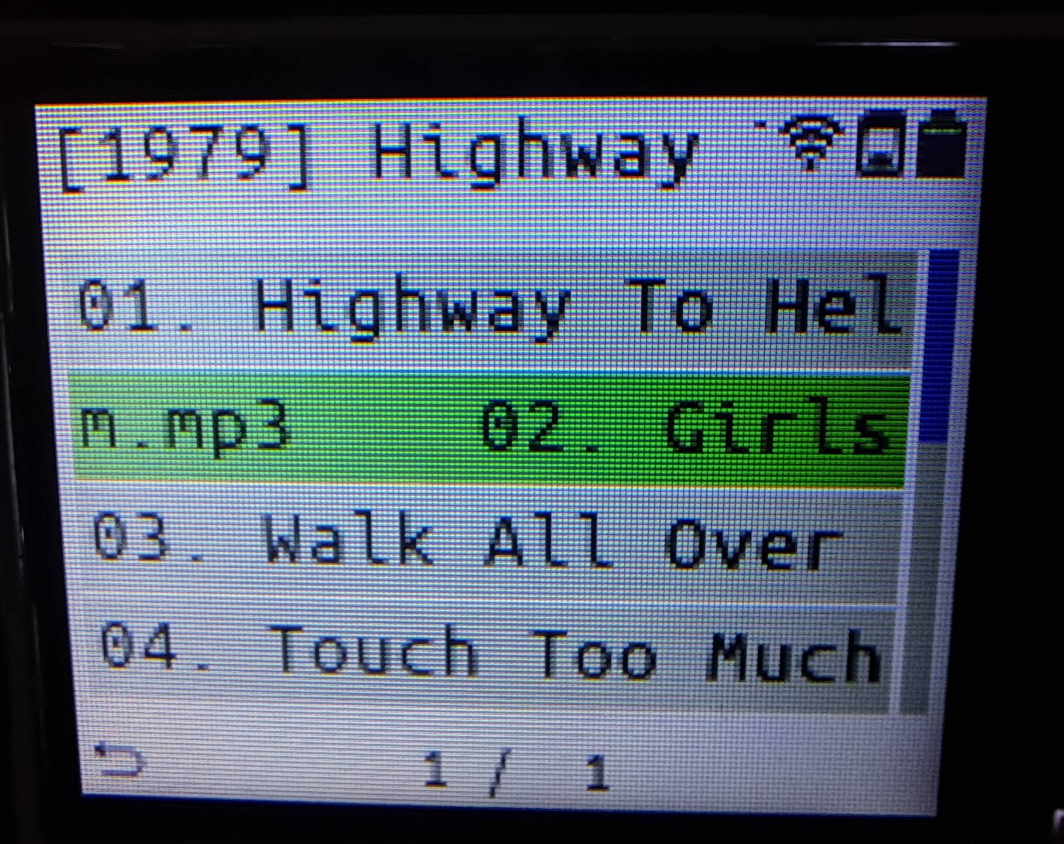
img/5/local.jpg
