MrJake222/pico-radio-docs/img/5/local_play.jpg

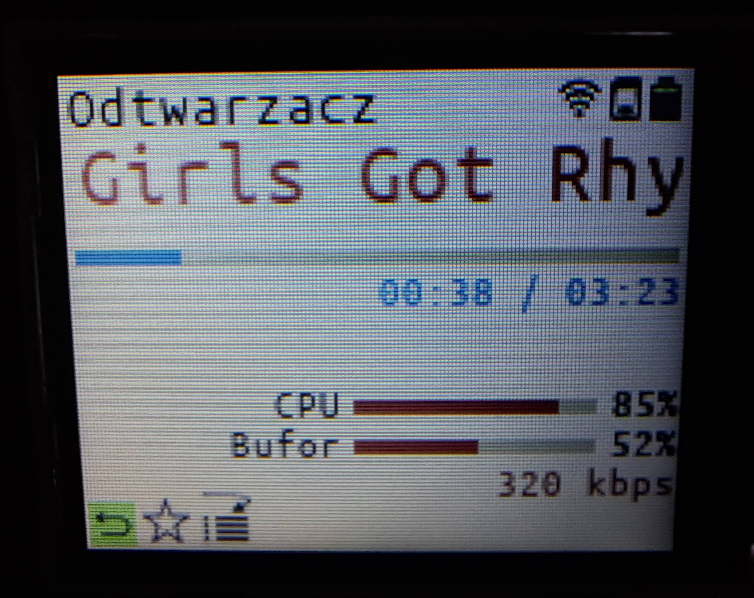
img/5/local_play.jpg
