MrJake222/pico-radio-docs/img/5/PicoRadio-fl-add.jpg

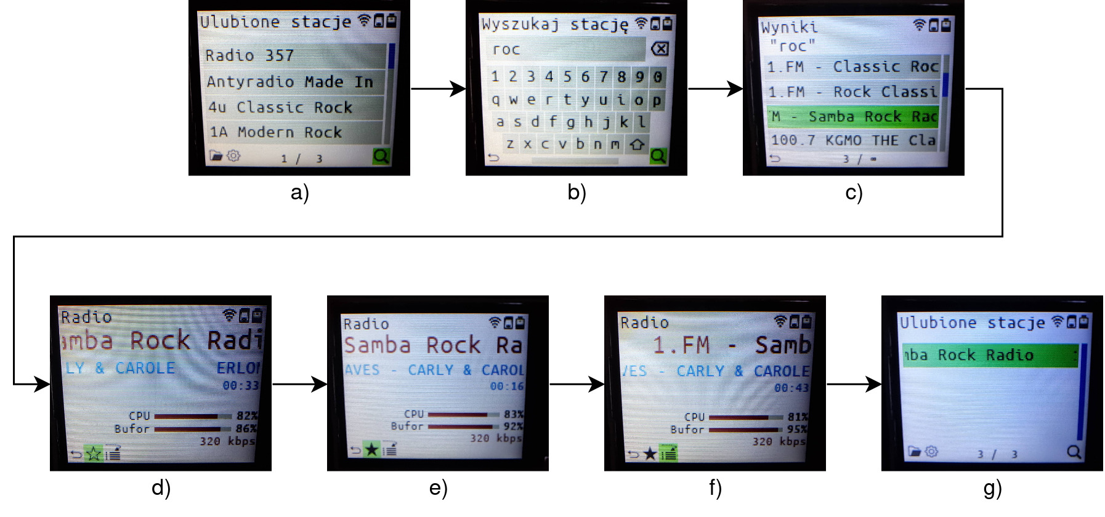
img/5/PicoRadio-fl-add.jpg
