MrJake222/pico-radio-docs/img/5/PicoRadio-fl-local.jpg

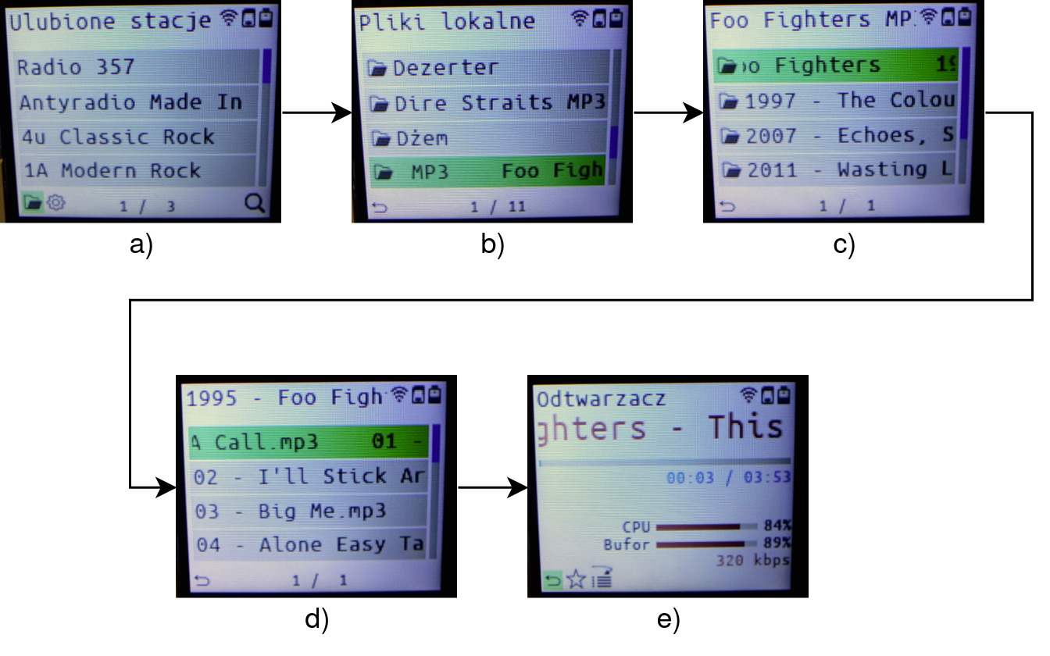
img/5/PicoRadio-fl-local.jpg
