MrJake222/pico-radio-docs/img/5/PicoRadio-fl-wifi.jpg

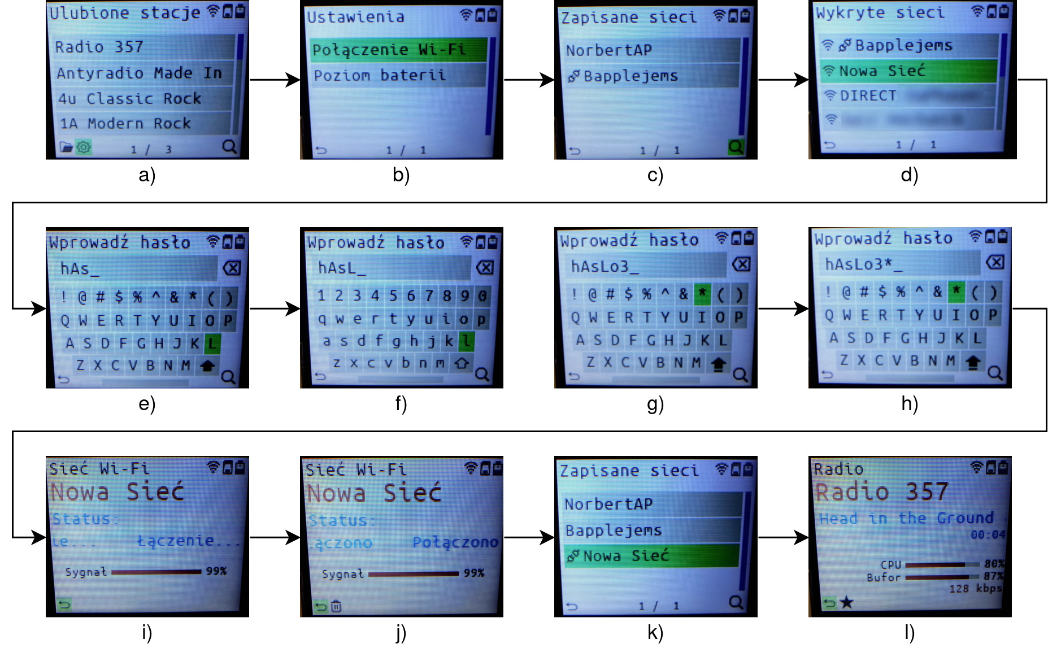
img/5/PicoRadio-fl-wifi.jpg
