MrJake222/pico-radio-docs/img/5/radio.jpg

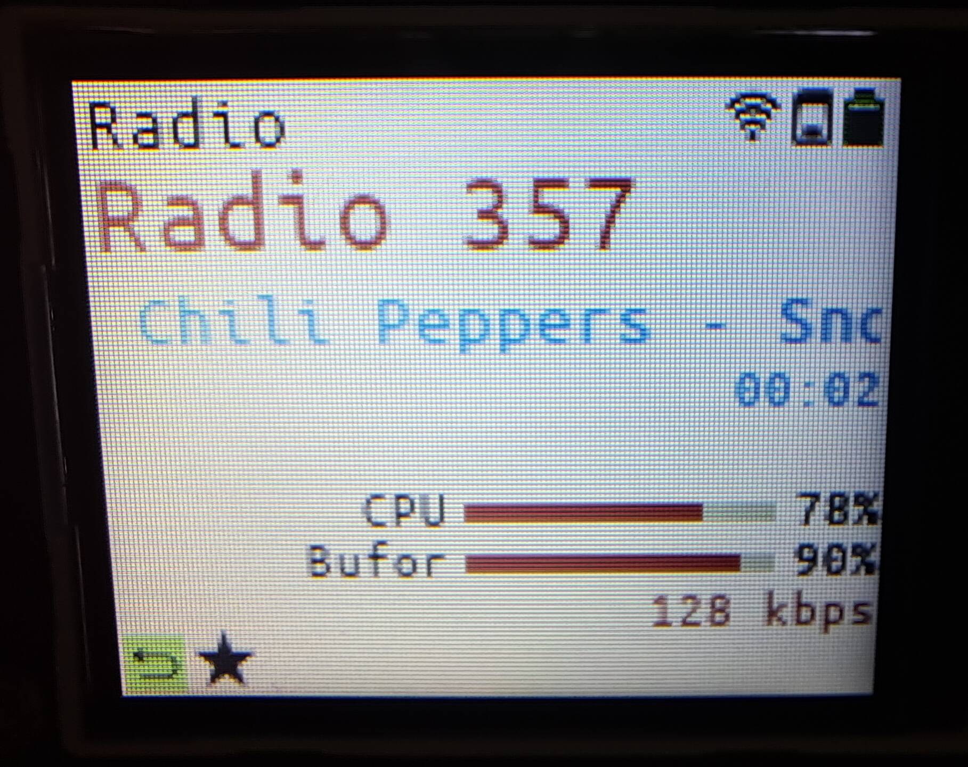
img/5/radio.jpg
