MrJake222/pico-radio-docs/img/5/radio_search.jpg

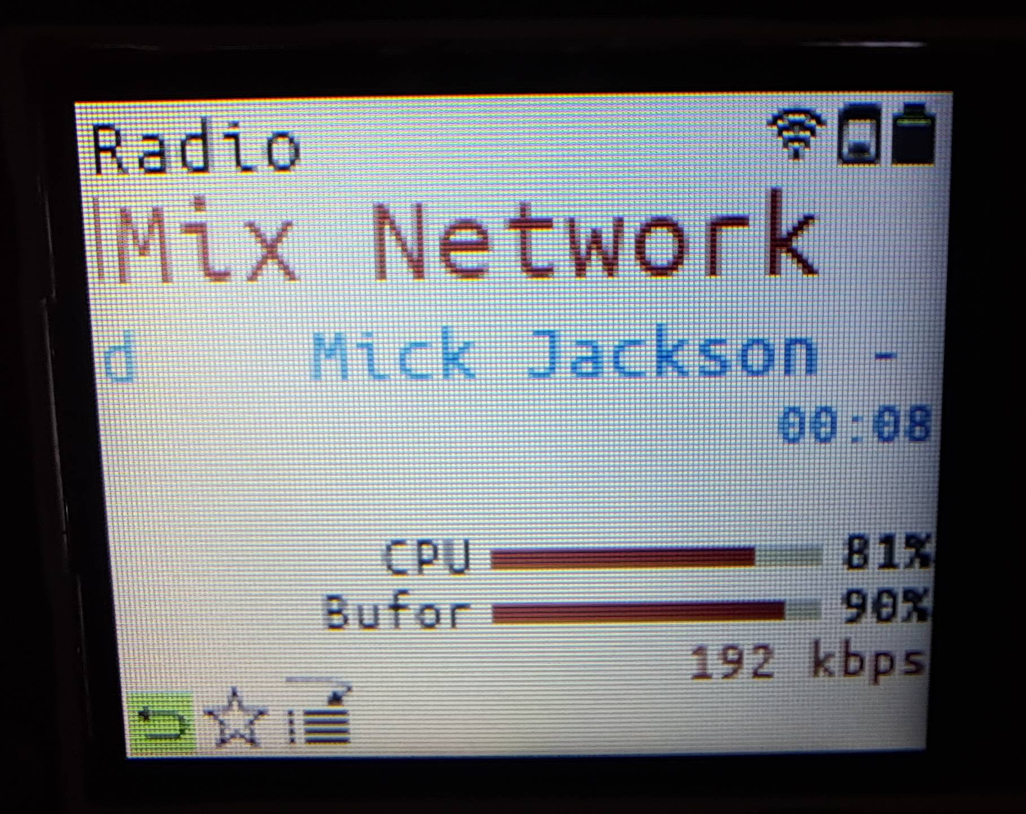
img/5/radio_search.jpg
