MrJake222/pico-radio-docs/img/5/searchres.jpg

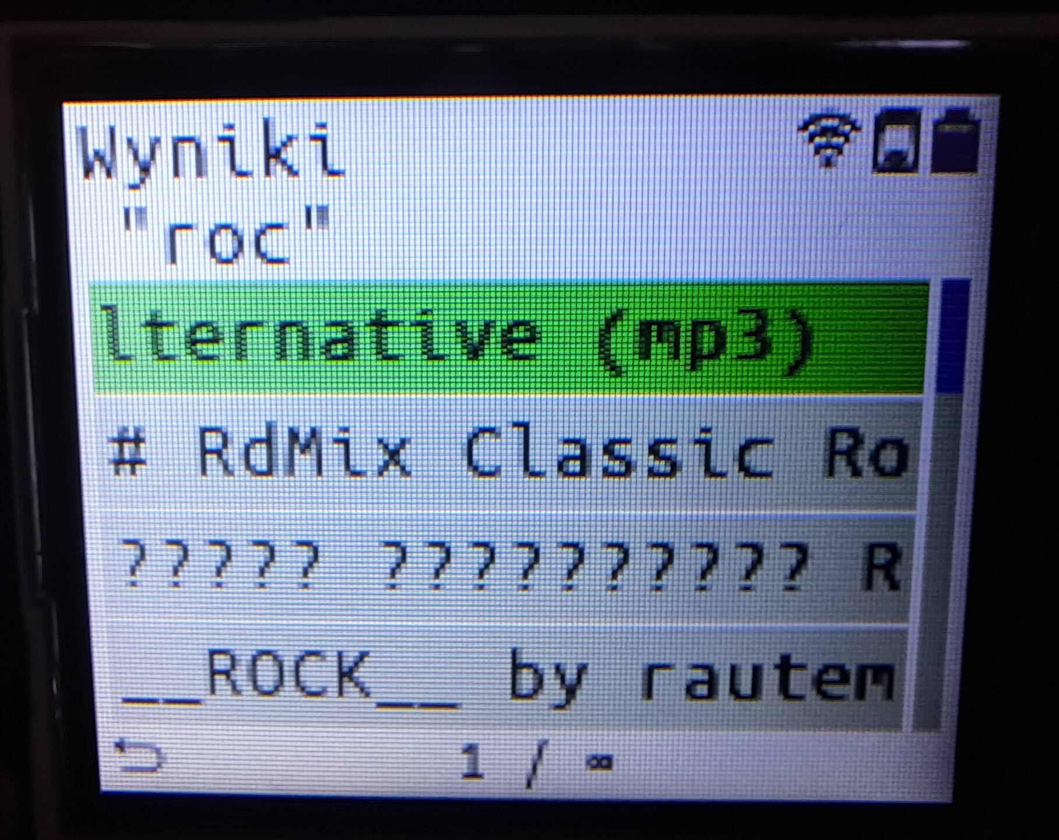
img/5/searchres.jpg
