MrJake222/pico-radio-docs/img/4/PicoRadio-steps.pdf

Testowanie / Dokumentacja

2023

Określenie wymagań

Pierwszy prototyp

Biblioteka dekodująca

Kwiecień

Standaryzacja interfejsu

Radio internetowe

Maj

System FreeRTOS

Interfejs użytkownika

Czerwiec

Problemy z oknem TCP

Proces przyrostowy

Część sprzętowa

Pliki lokalne

Lipiec - Wrzesień

Automatyczne
połączenie Wi-Fi

Listopad - Grudzień
