MrJake222/pico-radio-docs/img/2/PicoRadio-hw-blocks.pdf

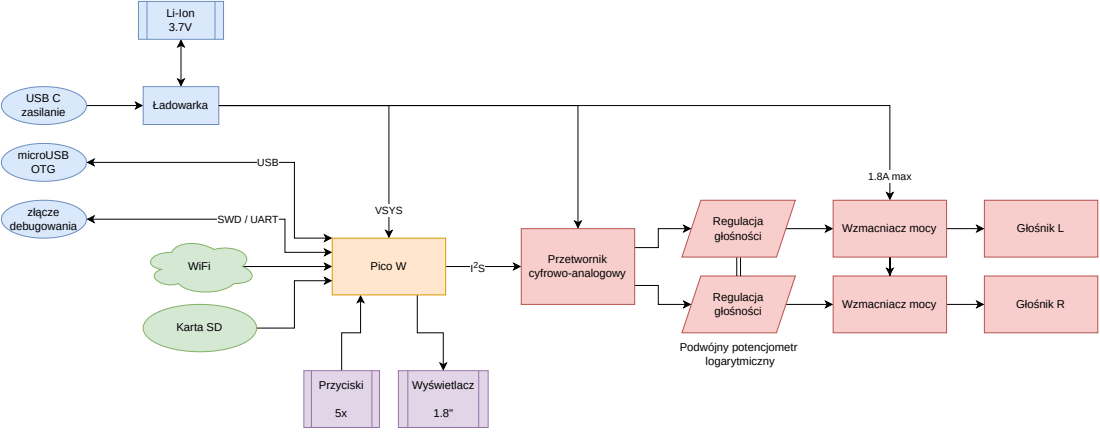
[picture p60: page 1]
USB; SWD / UART; WiFi; Pico W; Przetwornik; cyfrowo-analogowy; Wzmacniacz mocy; Głośnik L; Głośnik R; Karta SD; Regulacja głośności; Podwójny potencjometr logarytmiczny; Li-Ion 3.7V; VSYS; 1.8A max; Ładowarka USB C zasilanie; microUSB OTG; Przyciski; Wyświetlacz; złącze debugowania

Wzmacniacz mocy Regulacja
głośności
