MrJake222/pico-radio-docs/img/3/PicoRadio-sound-decoding.pdf

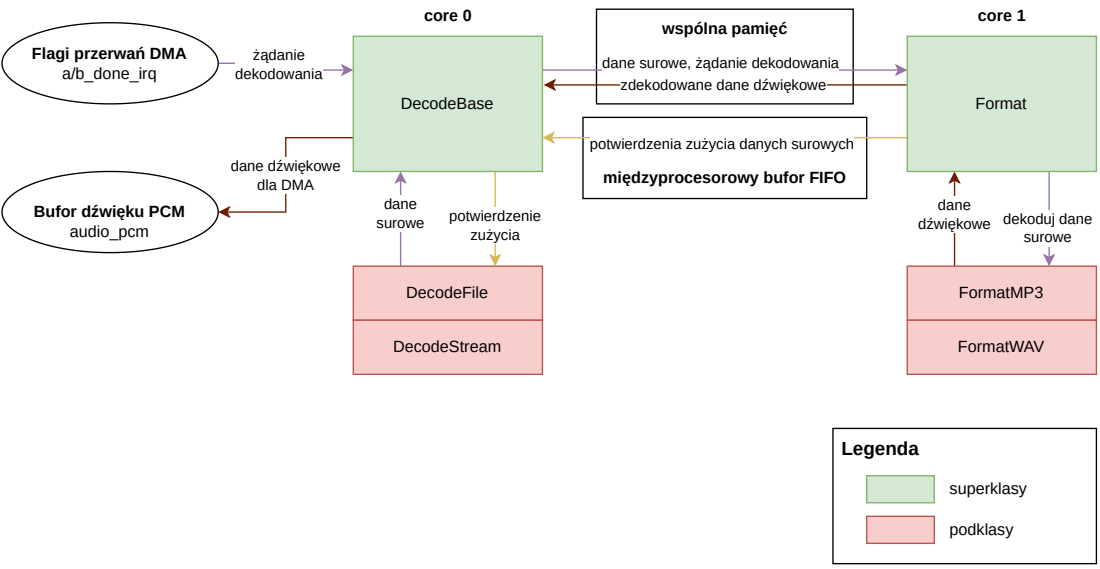
[picture p61: page 1]
wspólna pamięć; flagi; żądanie dekodowania; dane dźwiękowe dla DMA; core 0; core 1; dane dźwiękowe; FormatMP3; FormatWAV; dane surowe; DecodeFile; DecodeStream; dekoduj dane surowe; potwierdzenie zużycia; DecodeBase; Format; Legenda; superklasy; podklasy

Flagi przerwań DMA
a/b_done_irq

dane surowe, żądanie dekodowania
zdekodowane dane dźwiękowe

potwierdzenia zużycia danych surowych
międzyprocesorowy bufor FIFO

Bufor dźwięku PCM
audio_pcm
