MrJake222/pico-radio-docs/img/3/PicoRadio-buttons.pdf

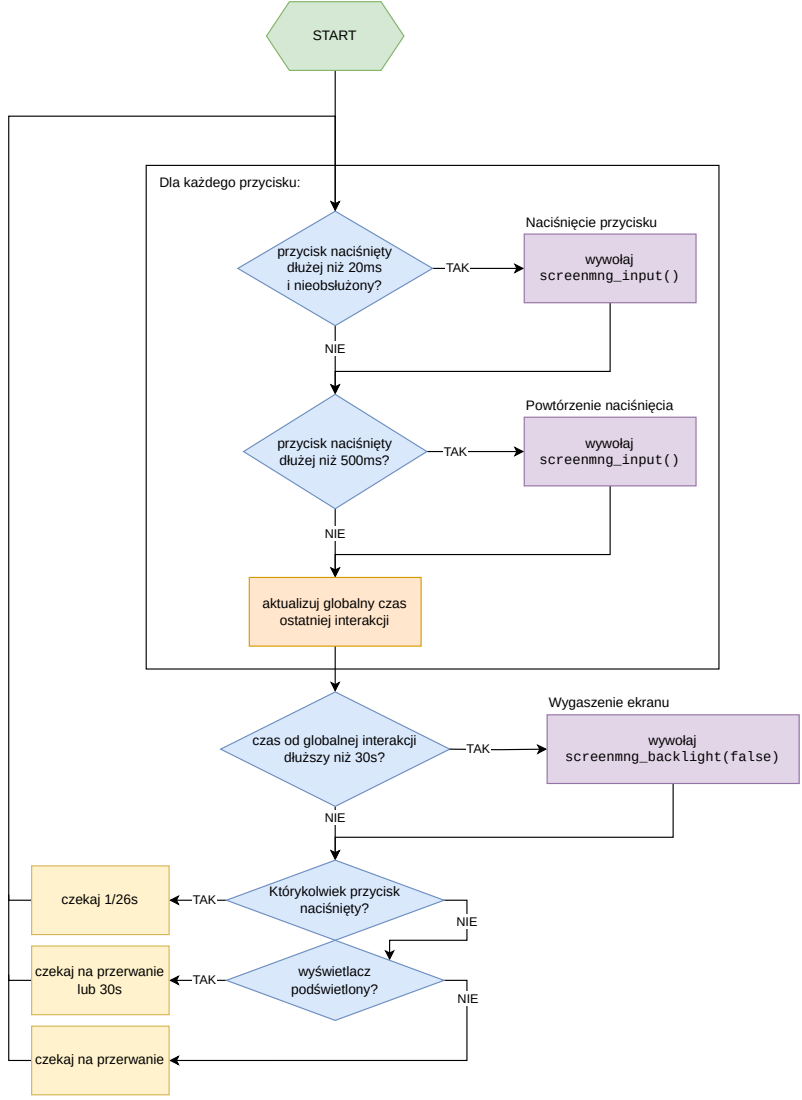
[picture p62: page 1]
TAK; NIE; przycisk naciśnięty dłużej niż 20ms i nieobsłużony?; START; wywołaj screenmng_input(); przycisk naciśnięty dłużej niż 500ms?; dłuższy niż 30s?; wywołaj; screenmng_backlight(false); Powtórzenie naciśnięcia; Którykolwiek przycisk; naciśnięty?; wyświetlacz podświetlony?; Wygaszenie ekranu; czekaj 1/26s; Naciśnięcie przycisku

Dla każdego przycisku:

aktualizuj globalny czas
ostatniej interakcji

czas od globalnej interakcji

czekaj na przerwanie
lub 30s
