MrJake222/pico-radio-docs/img/3/PicoRadio-screen-font.pdf

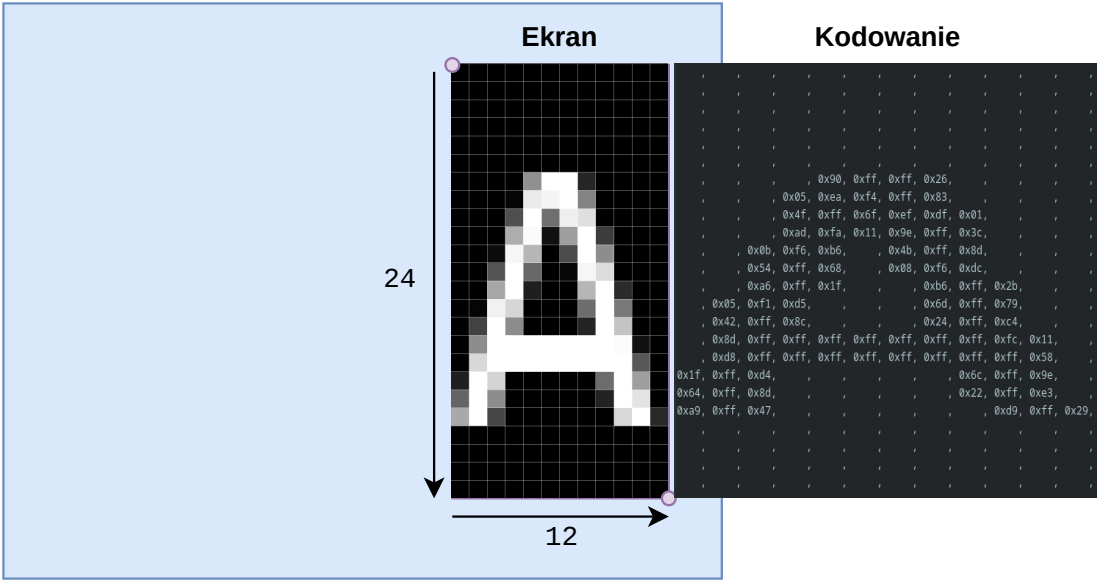
[picture p63: page 1]
Ekran; Kodowanie
