MrJake222/pico-radio-docs/img/3/PicoRadio-start.pdf

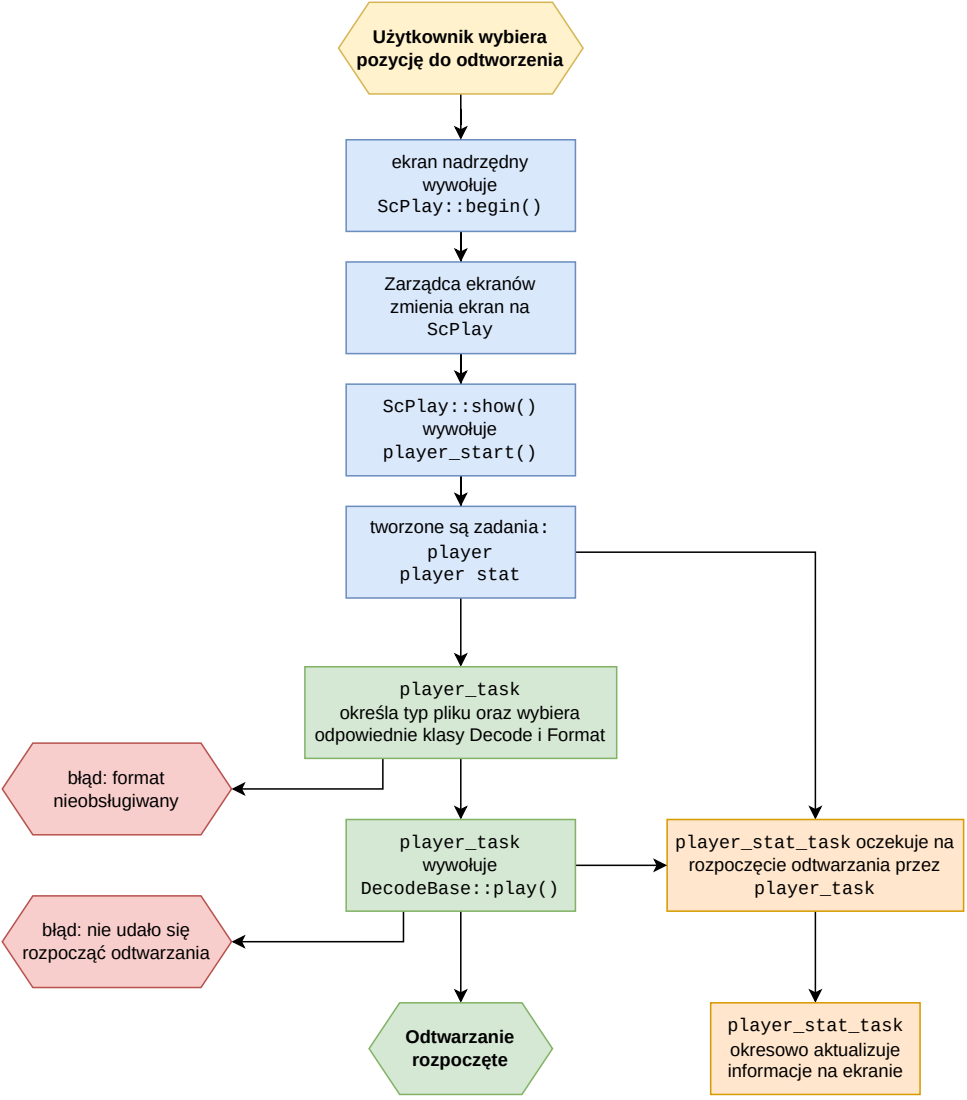
[picture p64: page 1]
ekran nadrzędny wywołuje ScPlay::begin(); ScPlay::show() wywołuje player_start(); player_task; player_task wywołuje DecodeBase::play(); Odtwarzanie rozpoczęte; błąd: format nieobsługiwany

Użytkownik wybiera
pozycję do odtworzenia

Zarządca ekranów
zmienia ekran na
ScPlay

tworzone są zadania:
player
player stat

player_task
określa typ pliku oraz wybiera
odpowiednie klasy Decode i Format

player_stat_task oczekuje na
rozpoczęcie odtwarzania przez

błąd: nie udało się
rozpocząć odtwarzania

player_stat_task
okresowo aktualizuje
informacje na ekranie
