MrJake222/pico-radio-docs/img/3/PicoRadio-stop.pdf

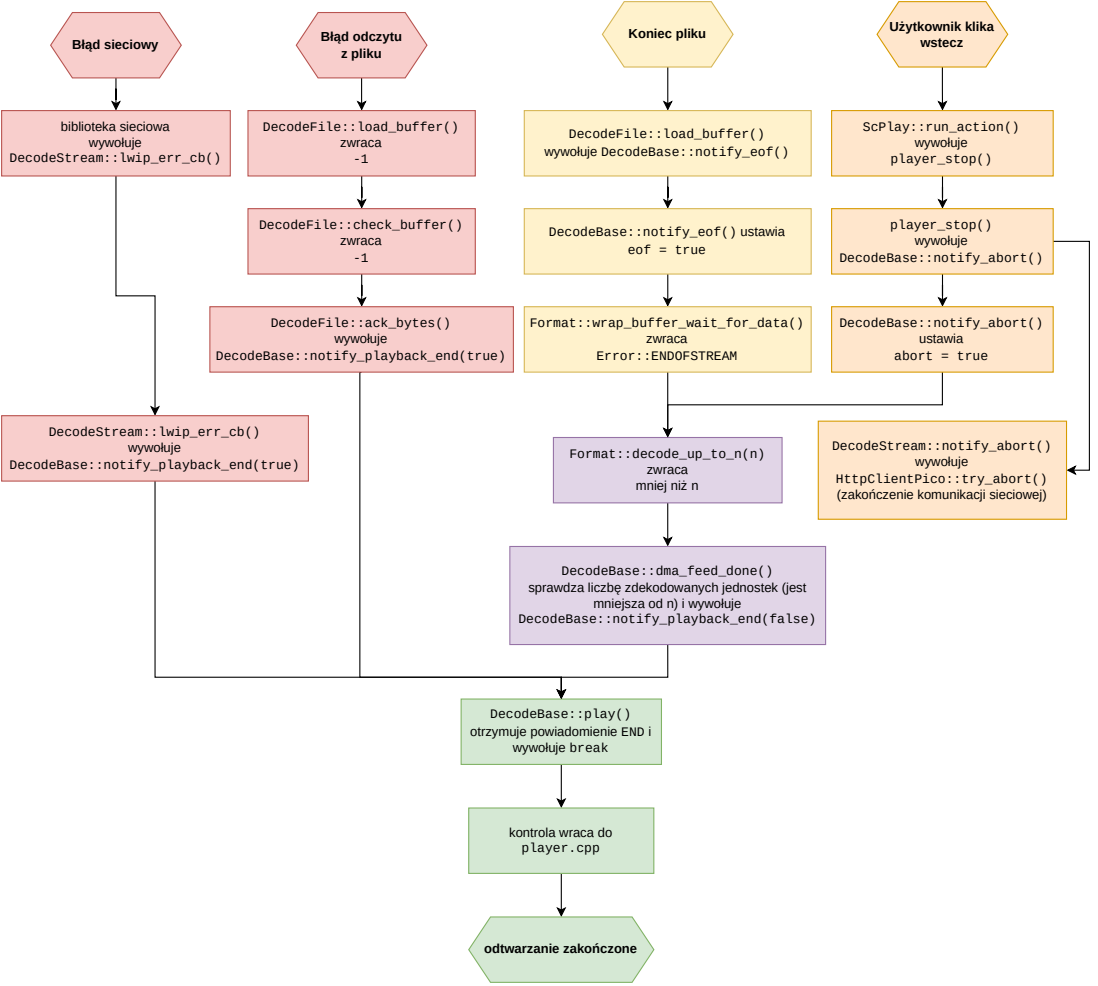
[picture p65: page 1]
Użytkownik klika wstecz; ScPlay::run_action() wywołuje player_stop(); player_stop() wywołuje DecodeBase::notify_abort(); DecodeBase::notify_abort() ustawia abort = true; DecodeStream::notify_abort() wywołuje; Format::decode_up_to_n(n) zwraca mniej niż n; Koniec pliku; DecodeFile::load_buffer() wywołuje DecodeBase::notify_eof(); DecodeBase::notify_eof() ustawia eof = true; Format::wrap_buffer_wait_for_data() zwraca Error::ENDOFSTREAM; Błąd odczytu z pliku; DecodeFile::load_buffer() zwraca -1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

HttpClientPico::try_abort()
(zakończenie komunikacji sieciowej)

DecodeBase::dma_feed_done()
sprawdza liczbę zdekodowanych jednostek (jest

mniejsza od n) i wywołuje

DecodeBase::play()
otrzymuje powiadomienie END i
wywołuje break

kontrola wraca do
player.cpp
