MrJake222/pico-radio-docs/img/2/interface/PicoRadio-flow.pdf

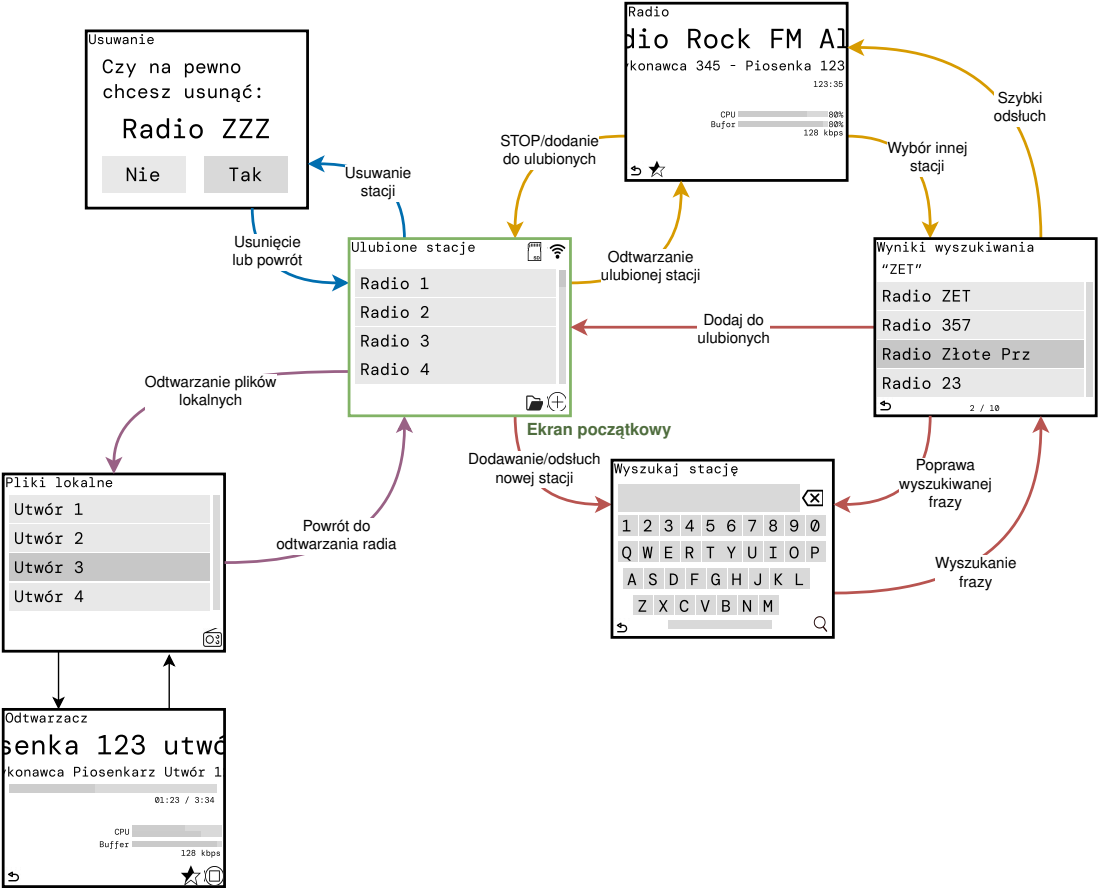
[picture p66: page 1]
Powrót do odtwarzania radia; STOP/dodanie; do ulubionych; Wybór innej; stacji Usuwanie; stacji; Usunięcie lub powrót; Dodawanie/odsłuch nowej stacji; Odtwarzanie ulubionej stacji; Odtwarzanie plików lokalnych; Dodaj do ulubionych; Szybki odsłuch; Wyszukanie frazy; Poprawa wyszukiwanej frazy; Ekran początkowy
