MrJake222/pico-radio-docs/(commit log)

2023-05-30 initial - wizja
    [siunitx-abbreviations.cfg]
2023-09-18 Reformatted flows, removed status icon flows
    TODO: remake flows with action icons
2023-09-18 new gfx for buttons
2023-10-05 better PIO/DMA
2023-10-10 Module schematic
2023-10-10 New electrical block diagram (/w buttons & display)
2023-12-09 Schematic WIP
2023-12-10 new buttons
2023-12-10 PCB/Case hw description
    [buttons.scad]
2023-12-30 C3 corrected
    Rodział 3 wstęp poprawiony
    PIO/DMA jako podsekcje, generalnie uporządkowane
    DMA rozwinięte
2024-01-05 C3, C4 fixed
    DMA rewritten
    4.1.2 end removed
    section names changed
    separated schematic
